SteveMayze/PowerSwap/Image/PowerSwap3d.png

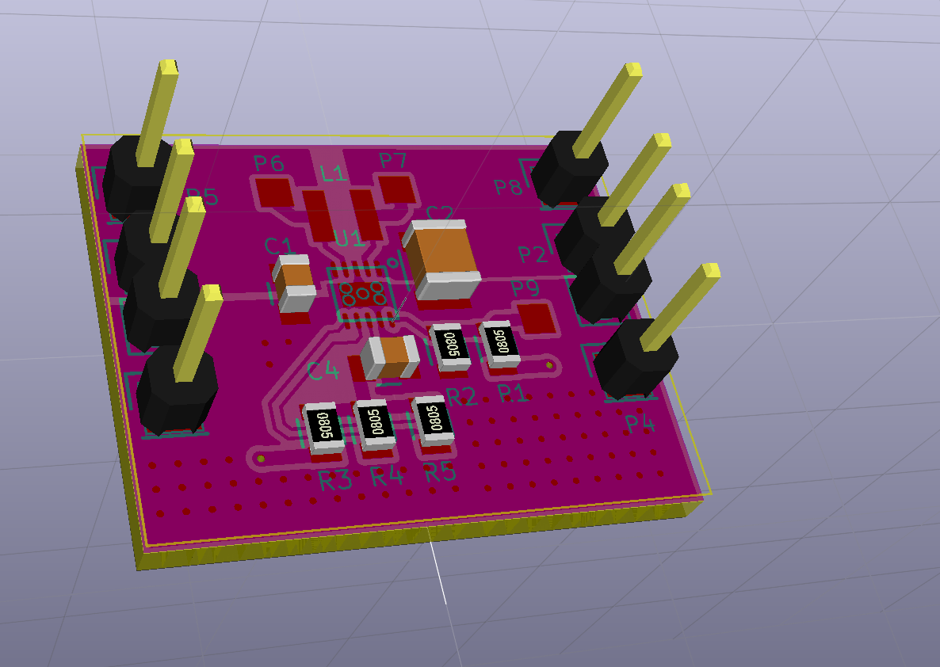
Image/PowerSwap3d.png
