SteveMayze/PowerSwap/Image/BuckBoost-TooMuchPaste.png

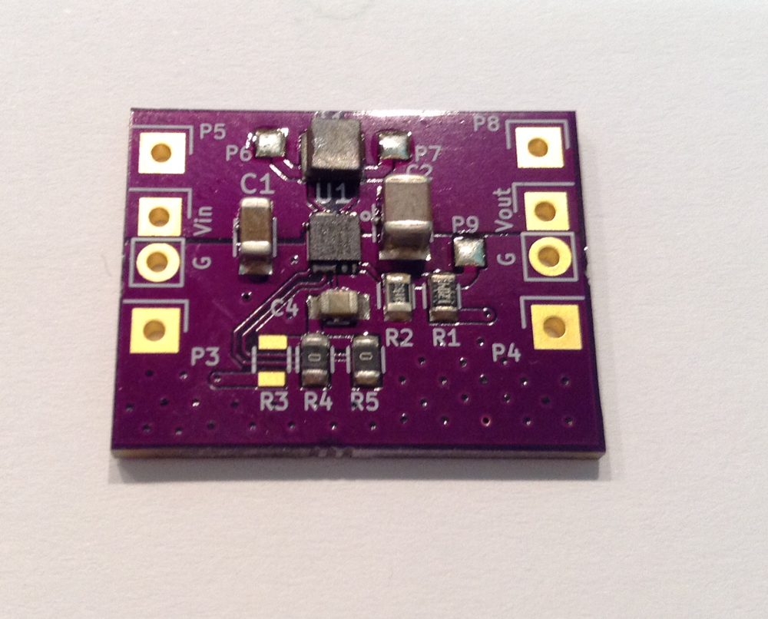
Image/BuckBoost-TooMuchPaste.png
