SteveMayze/PowerSwap/README.md

# PowerSwap
A Power control module for the Roll With it Project
