SteveMayze/PowerSwap/Boost/doc/Boost-Layout-Final.png

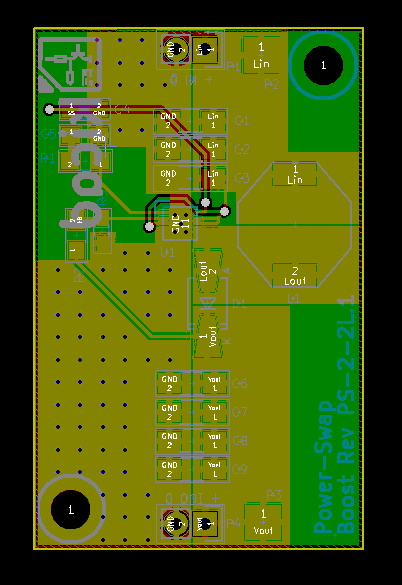
Boost/doc/Boost-Layout-Final.png
