SteveMayze/PowerSwap/Boost/doc/Boost-Layout.png

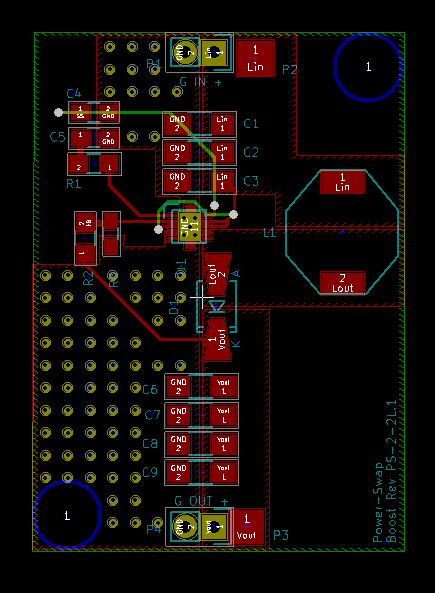
Boost/doc/Boost-Layout.png
