SteveMayze/PowerSwap/Boost/doc/PowerSwap-Boost-Connection.png

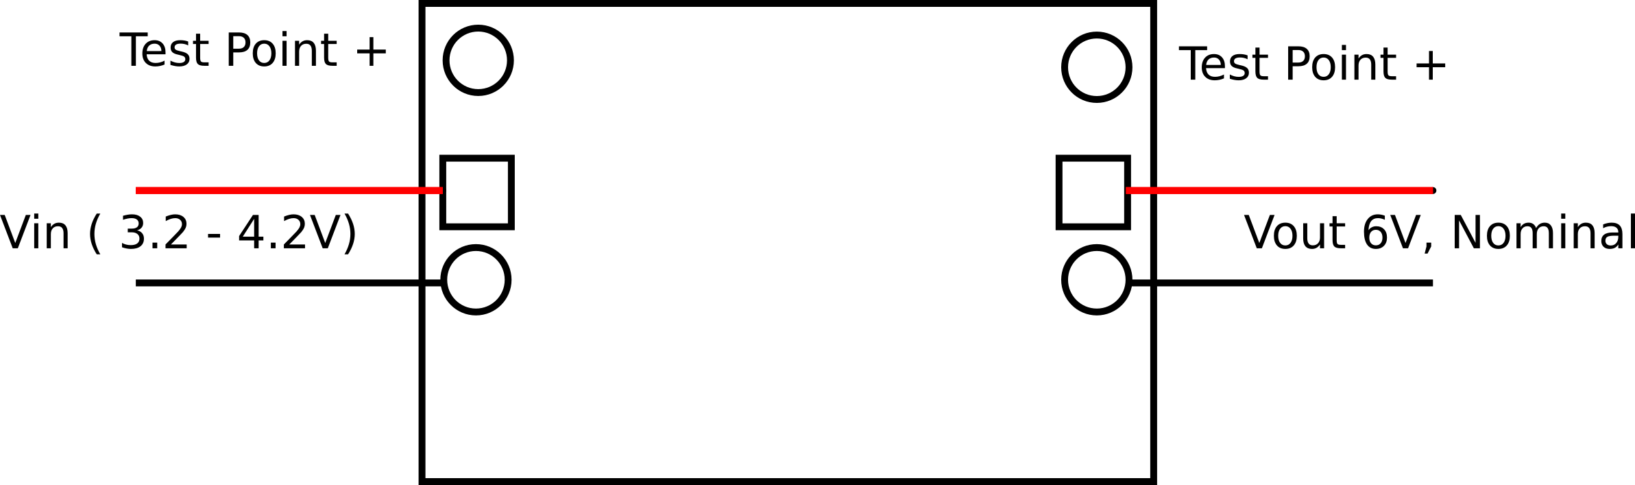
Boost/doc/PowerSwap-Boost-Connection.png
