SteveMayze/PowerSwap/Buck-Boost/doc/PowerSwap-BuckBoost-Connection.png

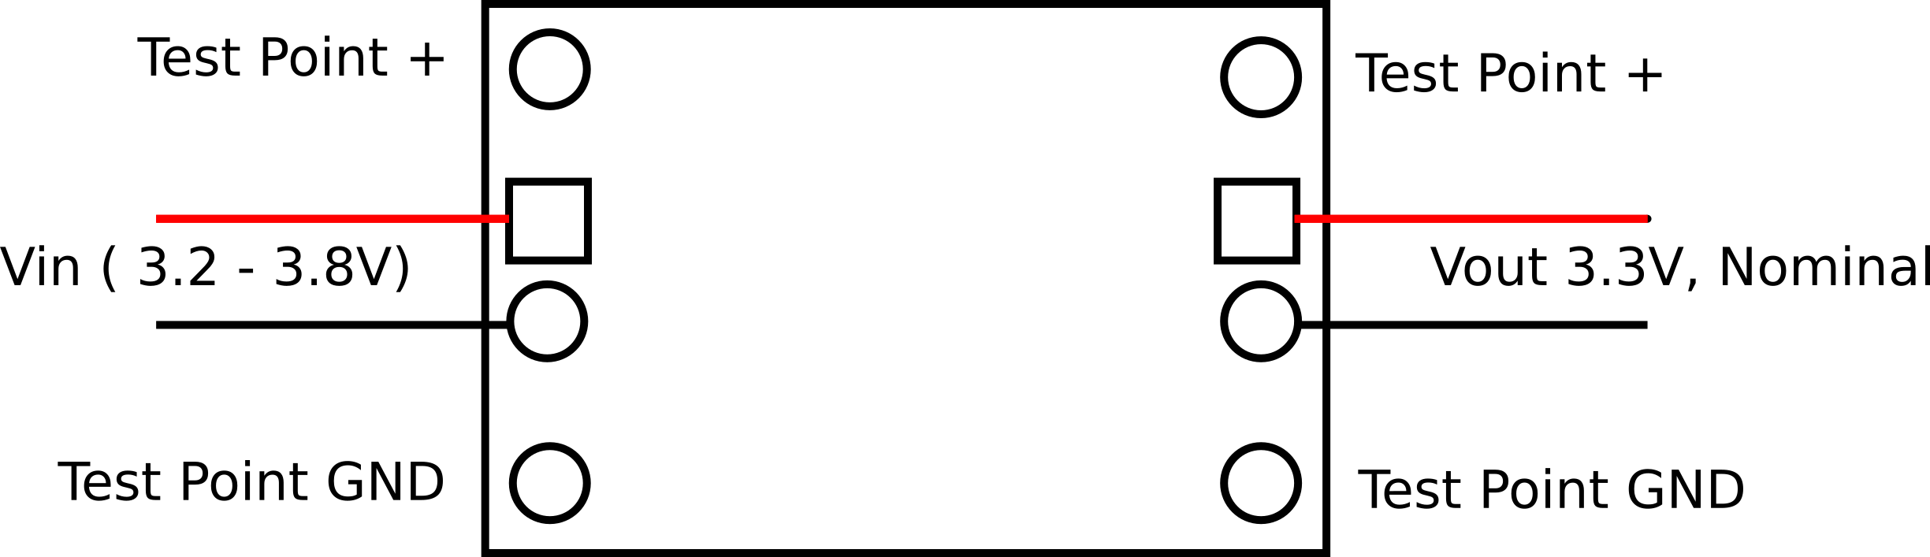
Buck-Boost/doc/PowerSwap-BuckBoost-Connection.png
