SteveMayze/PowerSwap/Image/Boost-InitialSchematic.png

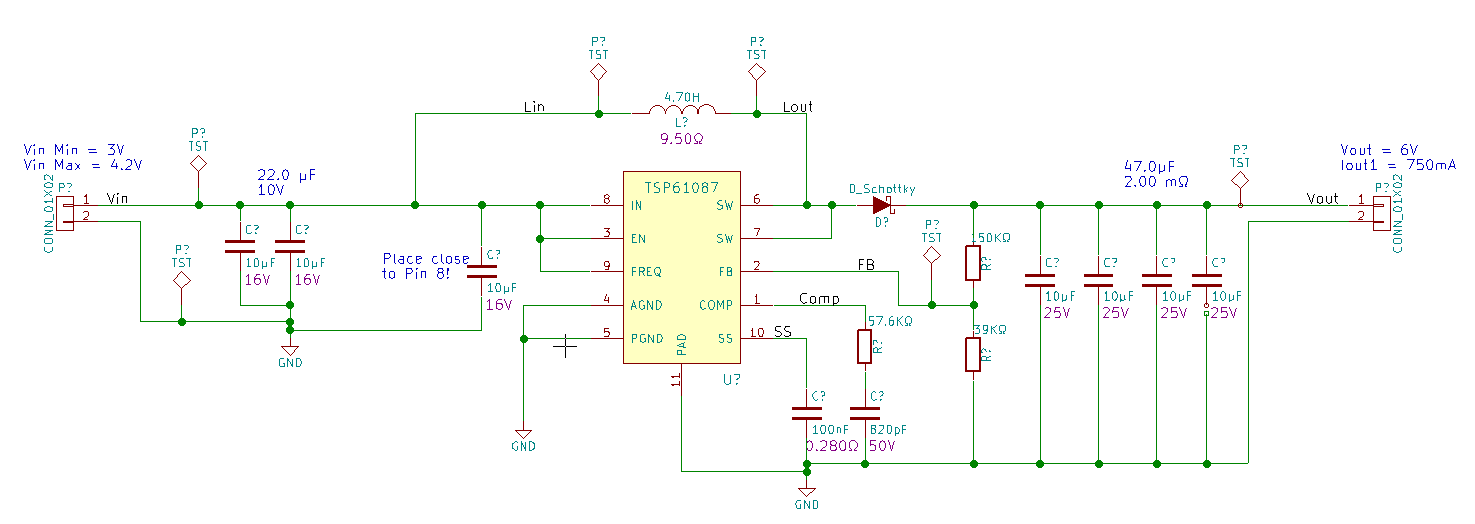
Image/Boost-InitialSchematic.png
