SteveMayze/PowerSwap/Image/Boost-ReferenceSchematic.png

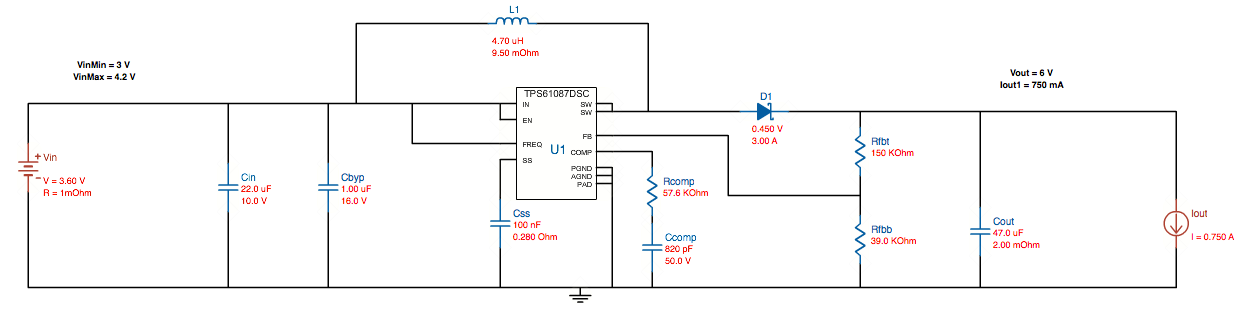
Image/Boost-ReferenceSchematic.png
