SteveMayze/PowerSwap/Image/BuckBoost-Working.png

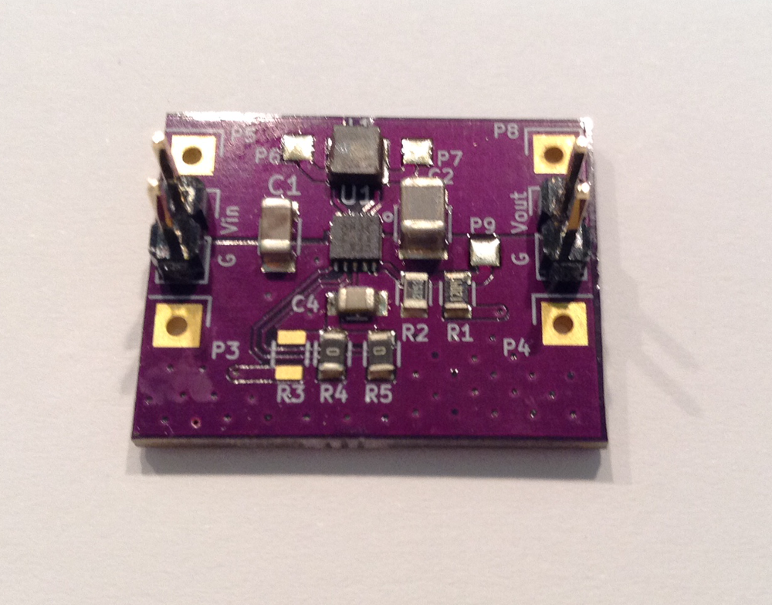
Image/BuckBoost-Working.png
