SteveMayze/PowerSwap/Image/BucknBoost3.png

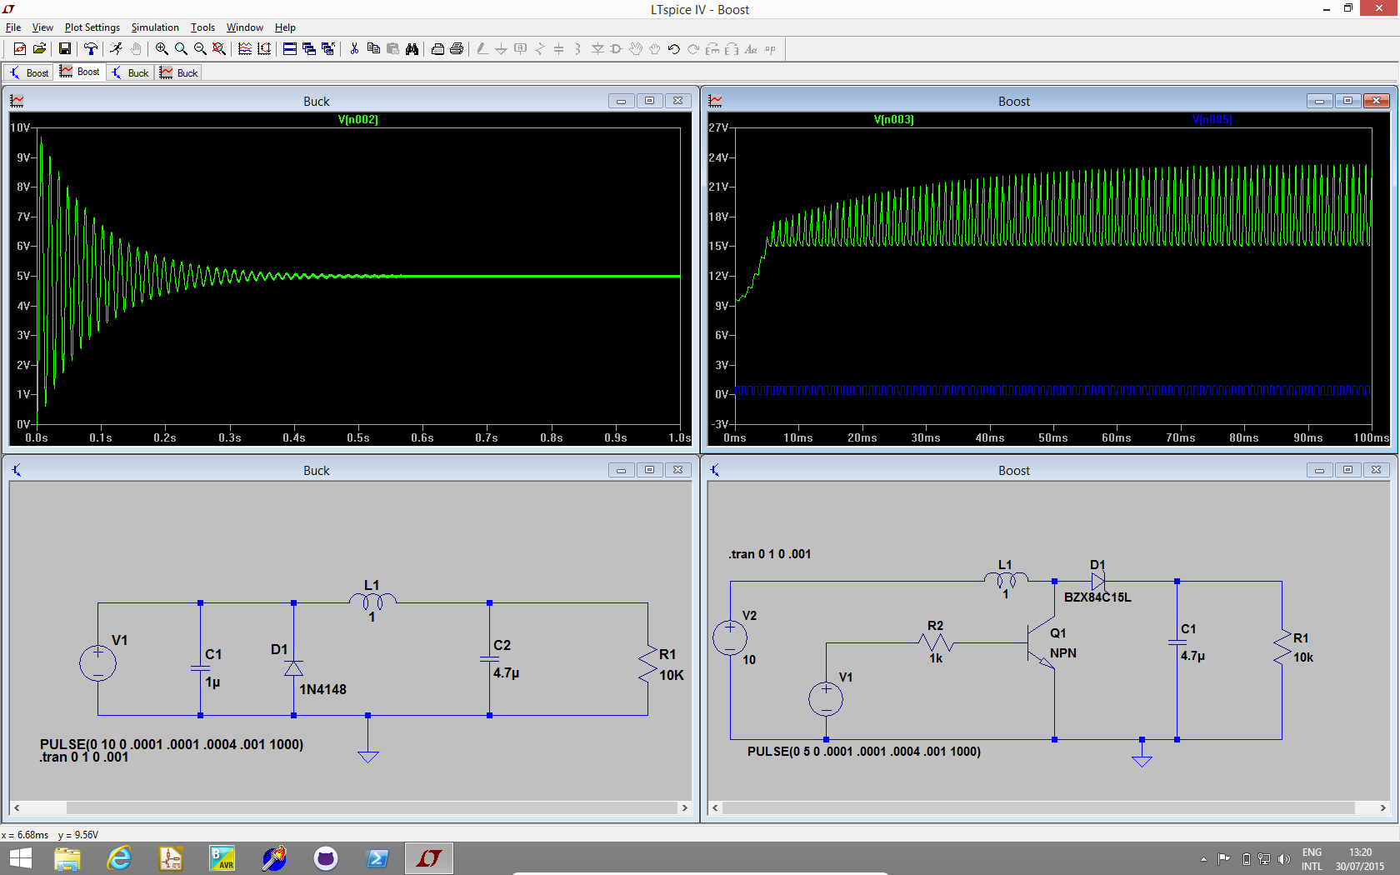
Image/BucknBoost3.png
