SteveMayze/PowerSwap/Image/PowerSwap-Boost-Schematic.png

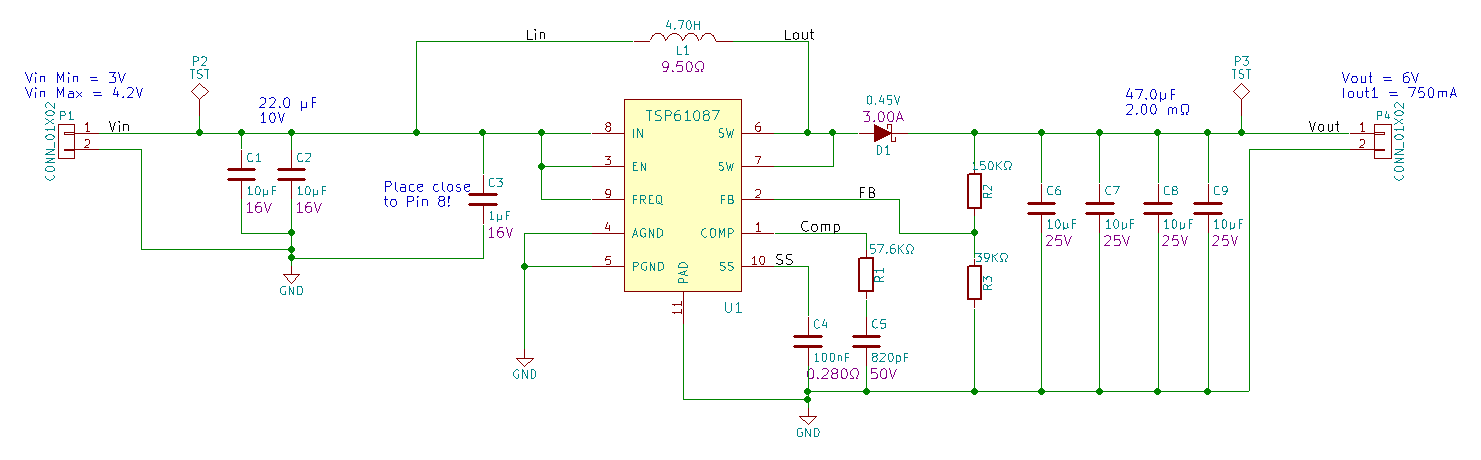
Image/PowerSwap-Boost-Schematic.png
