SteveMayze/PowerSwap/Image/PowerSwap-Layout-01.png

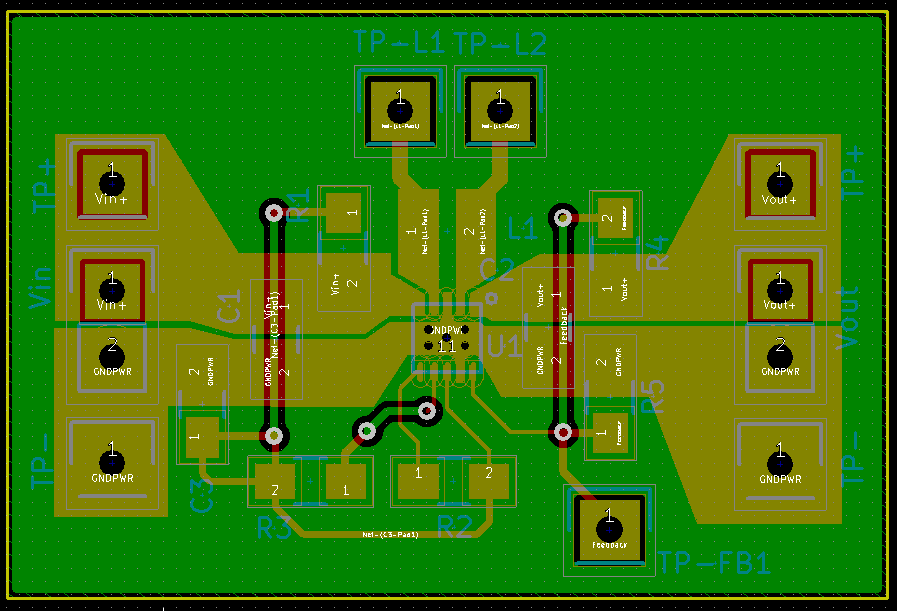
Image/PowerSwap-Layout-01.png
