SteveMayze/PowerSwap/Image/PowerSwap-Layout-BottomCopper.png

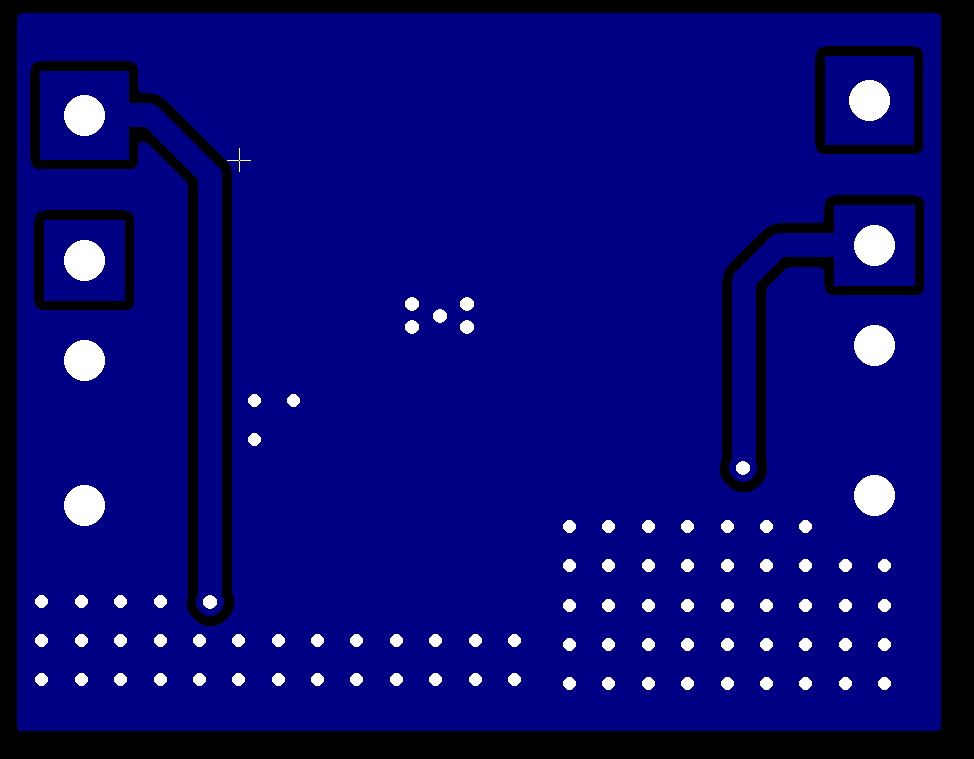
Image/PowerSwap-Layout-BottomCopper.png
