SteveMayze/PowerSwap/Image/PowerSwap-Layout-rev2.png

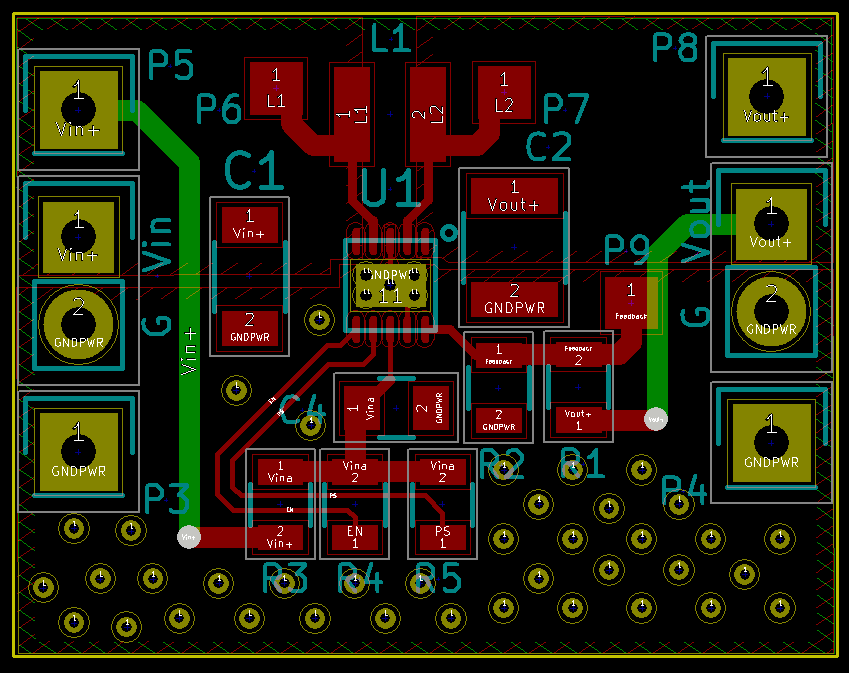
Image/PowerSwap-Layout-rev2.png
