SteveMayze/PowerSwap/Image/PowerSwap-Layout-TopCopper.png

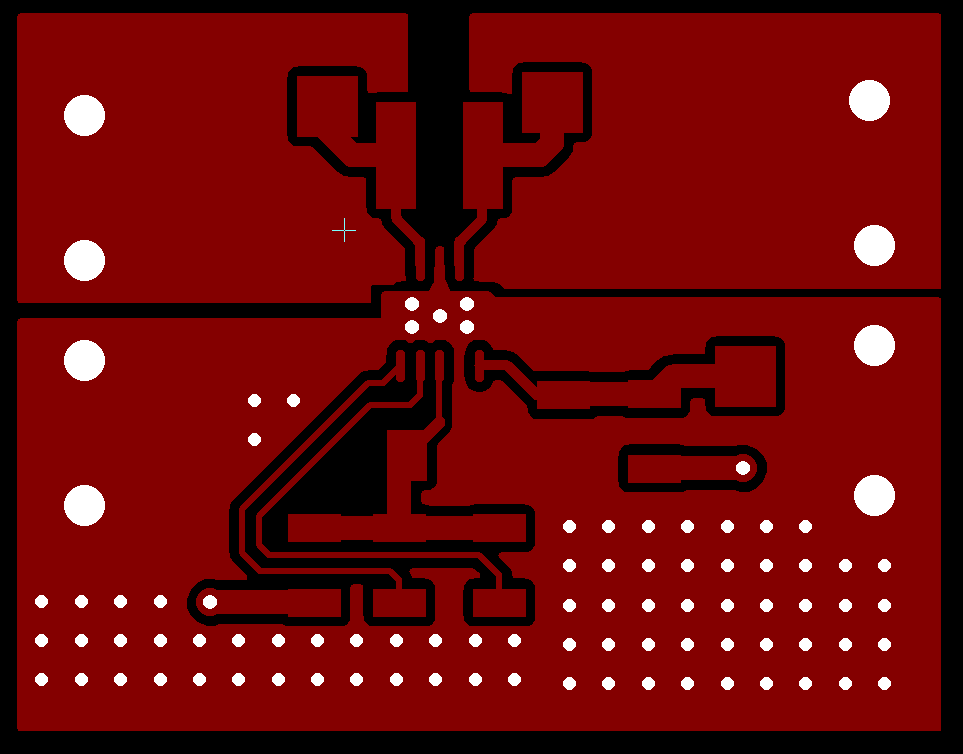
Image/PowerSwap-Layout-TopCopper.png
