SteveMayze/PowerSwap/Image/PowerSwap-Layout.png

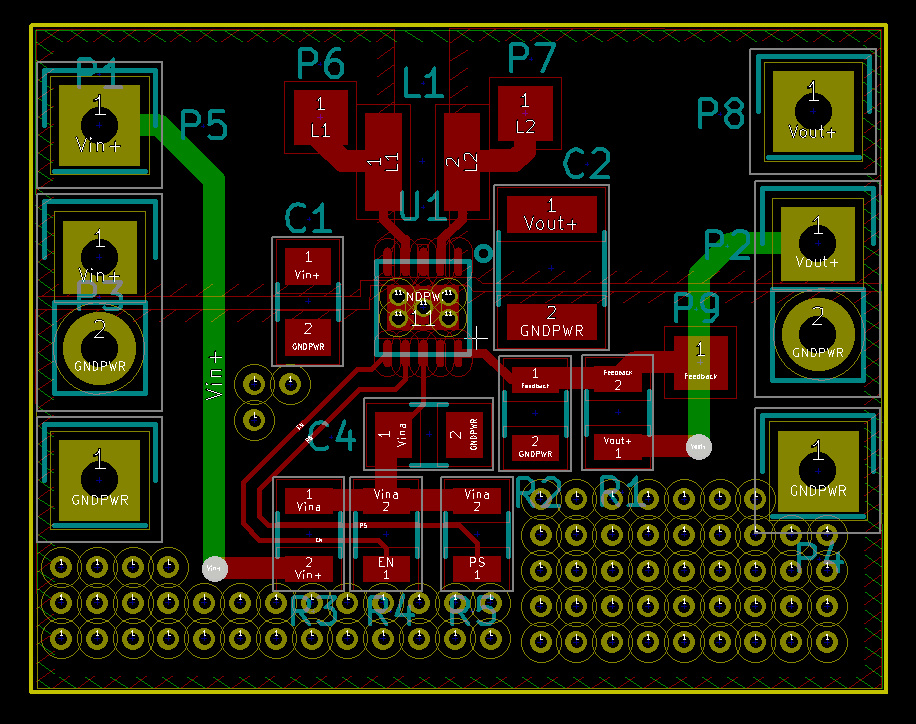
Image/PowerSwap-Layout.png
