SteveMayze/PowerSwap/Image/Schematic-150801.png

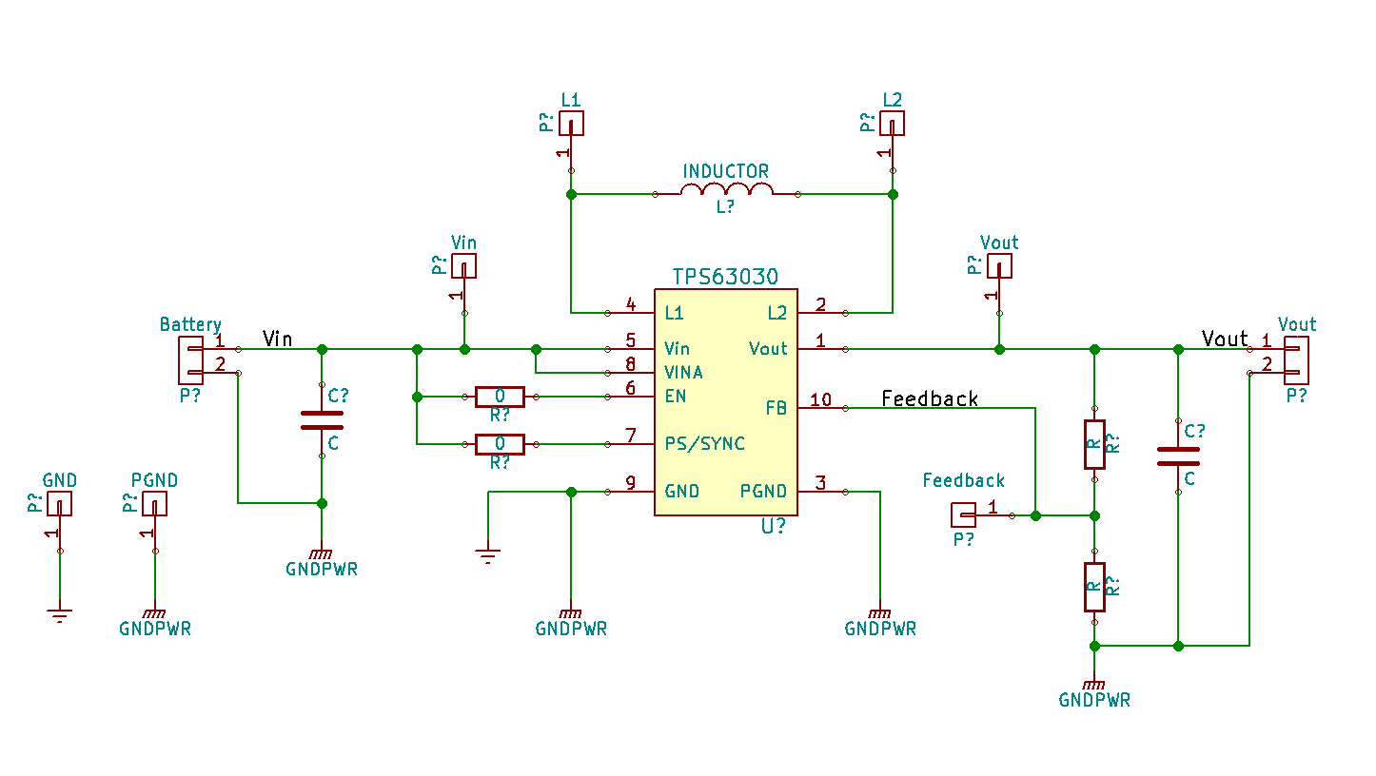
Image/Schematic-150801.png
