SteveMayze/PowerSwap/Image/Schematic-151121.png

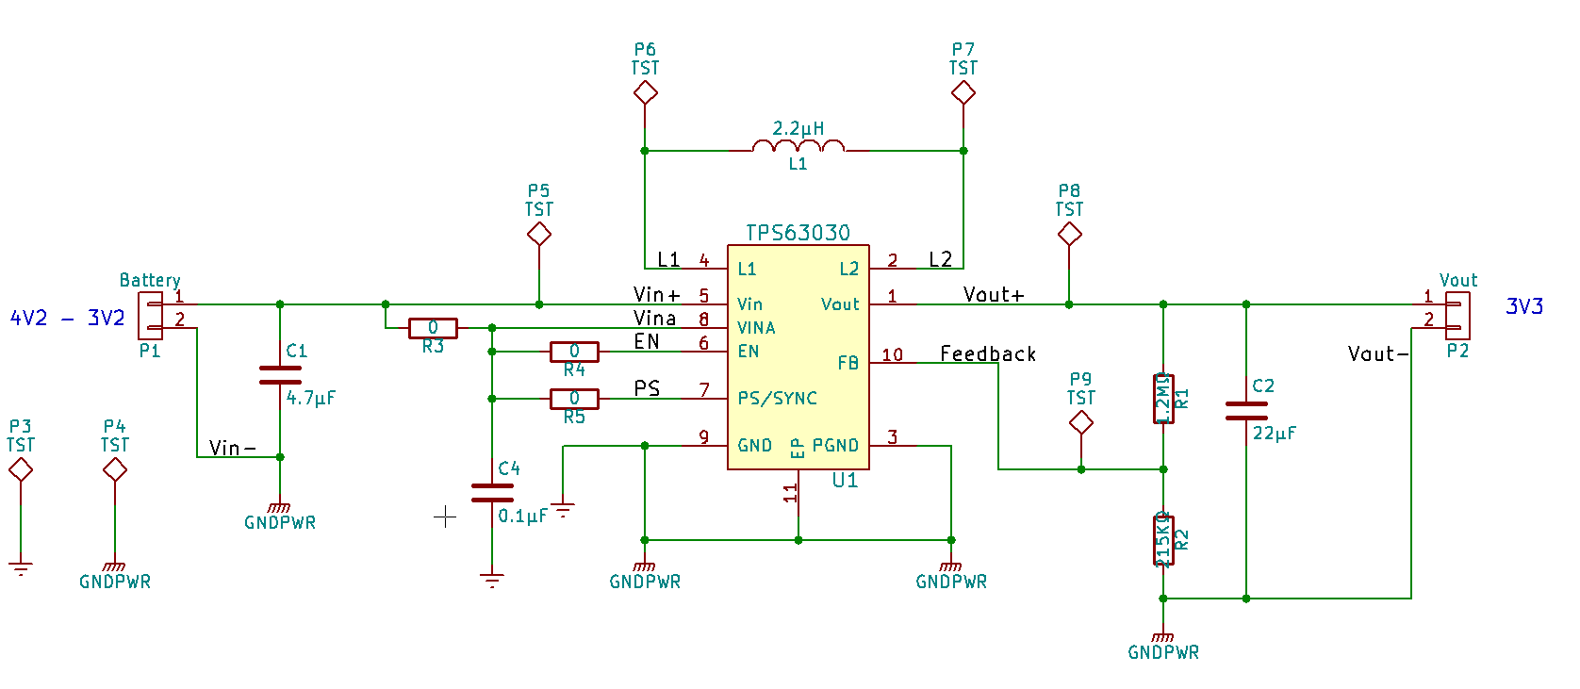
Image/Schematic-151121.png
