SteveMayze/PowerSwap/Buck-Boost/doc/ComponentValues.pdf

R1

Page 1

Vin2 | 3 V
Vin1 | 4.2 V
Vout | 3.3 V
Vfb | 0.5 V
R1 | 1204000 Ω
R2 | 215000 Ω | 2.33E-06

Inductor

Page 2

V from the data sheet calculations
Lbuck | 0.00000045 H | | 1.5 | 3
Lboost | 0.00000165 H | 0.0000022 | 4.7 | 6.1

Current

Page 3

f | 2200000.000 Hz
Iout | 0.100 A
I1 | 0.198 A | 0.222402597
I2 | 0.166 A

Cout

Page 4

E3
Cout | 0.000011 F | 22 μF
