SteveMayze/PowerSwap/Buck-Boost/doc/ComponentValues.numbers/preview-web.jpg

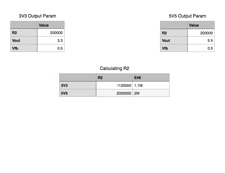
Buck-Boost/doc/ComponentValues.numbers/preview-web.jpg
