SteveMayze/PowerSwap/Boost/doc/PowerSwap-Boost-TestResults.pdf

## Test Results

## Constant Supply

The test results show the behaviour of the system with a constant supply voltage and varied load from 0 through to 600mA. The system load represents the current drawn by the system as reported on the laboratory power supply.

## 3.2V Constant supply

0 | 0.100 | 0.200 | 0.300 | 0.400 | 0.500 | 0.600

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
## Output Voltage by Load @ 3V2 (Boost)

Output Voltage System Load

Load Current (Amperes)

Output (Volts)

Load Current | Output Voltage System Load
0.000 | 5.970 | 0.003
0.100 | 5.960 | 0.215
0.200 | 5.960 | 0.420
0.300 | 5.960 | 0.663
0.400 | 5.960 | 0.951
0.500 | 5.960 | 1.265
0.600 | 4.560 | 1.150

## 4.2V Constant Supply

Load Current | Output Voltage | System Load
0.000 | 5.970 | 0.001
0.100 | 5.960 | 0.155
0.200 | 5.960 | 0.316
0.300 | 5.960 | 0.480
0.400 | 5.960 | 0.663
0.500 | 5.960 | 0.851
0.600 | 5.950 | 1.610
0.000 | 0.100 | 0.200 | 0.300 | 0.400 | 0.500 | 0.600

5.94

5.95

5.95

5.96

5.96

5.97

5.97

5.98

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
## Output Voltrage by Load @ 4V2 (Boost)

Output Voltage System Load

Load Current (Amperes)

Output (Volts)

## Connection

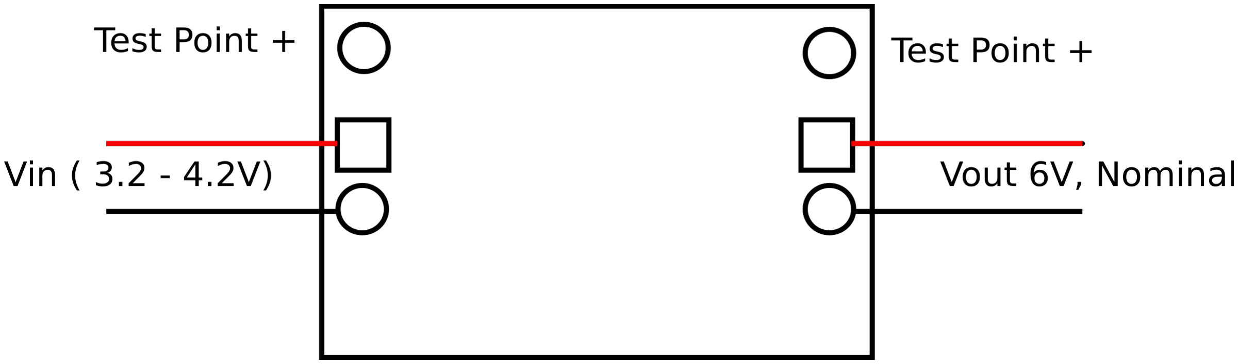
[picture p20: figure]

## Schematic

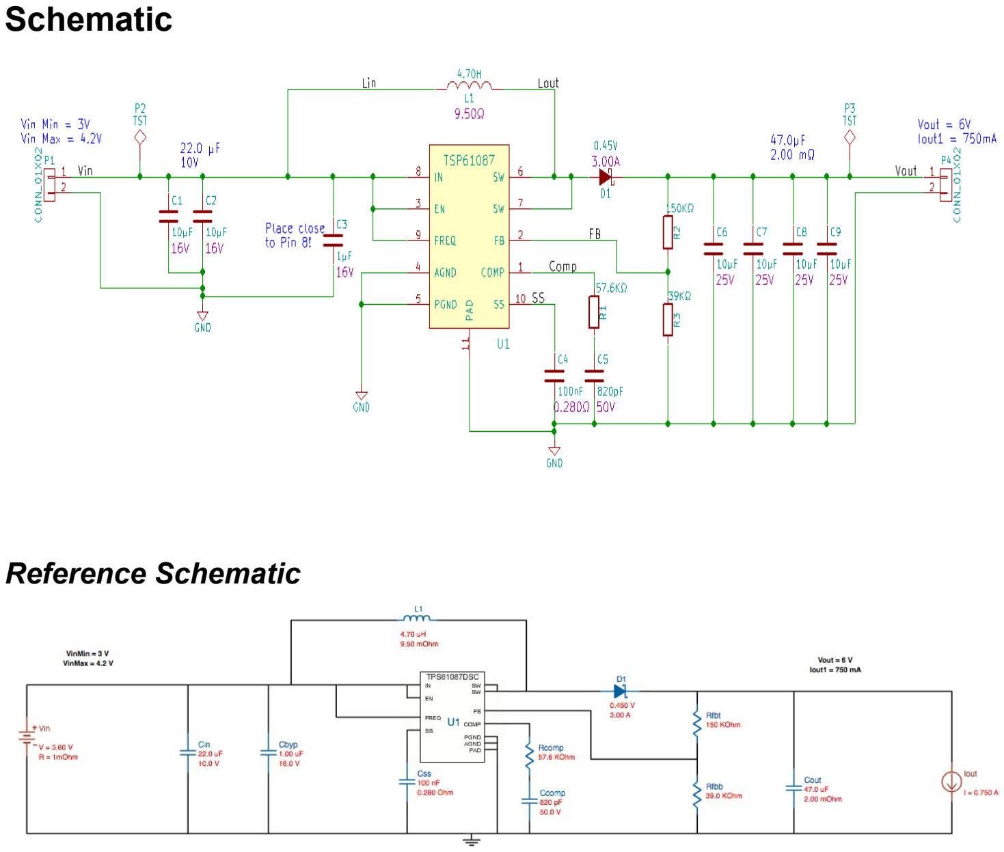
[picture p21: page 4]

## Reference Schematic
