SteveMayze/PowerSwap/Buck-Boost/doc/PowerSwap-BuckBoost-TestResults.pdf

# Test Results

# Constant Supply

The test results show the behaviour of the system with a constant supply voltage and varied load from 0 through to 500mA. The system load represents the current drawn by the system as reported on the laboratory power supply.

Load Current | Output Voltage | System Load
0.000 | 3.279 | 0.005
0.100 | 3.274 | 0.085
0.200 | 3.270 | 0.173
0.300 | 3.266 | 0.266
0.400 | 3.262 | 0.363
0.500 | 3.261 | 0.483
0.000 | 0.100 | 0.200 | 0.300 | 0.400 | 0.500

3.25

3.26

3.27

3.28

0

0.1

0.2

0.3

0.4

0.5

0.6

# Output Voltage by Load @ 4V2 (Buck)

# Output Voltage System Load

# Load Current

# Ouput Voltage

# Input Voltage3.2V

# Load CurrentOutput Voltage System Load

0.000 | 3.279 | 0.005
0.100 | 3.278 | 0.113
0.200 | 3.279 | 0.230
0.300 | 3.279 | 0.375
0.400 | 3.282 | 0.530
0 | 0.1 | 0.2 | 0.3 | 0.4 | 0.5

3.24

3.26

3.28

3.3

# Output Voltage by Load @ 3V2 (Boost)

# Load Current

# Output Voltage

# System Test

The results show the behaviour of a full system test. This is the Power Swap Buck-Boost module being supplied by the Full Charge Ahead (FCA) module, which is also charging a Lithium ION battery. An active load will be simulated using the Current Sink or Swim (CSoS) module.
The idea is to ascertain how the system will behave over time under load with no charge and then again with a constant charge from the FCA module.

# Set up

The modules are interconnected as per the diagram below. The CSoS acts as an active load drawing current from the Li-ION cell via the Power Swap Buck-Boost module. It is expected that the CSoS is delivered the required current at a constant voltage of 3.3V.

# Expected Behaviour

When the system is supplied from an external source i.e. 5V supply via the USB connector, it is expected that there should be no variation in the behaviour of the system. Once the 5V supply is removed (on a fully charged system) no immediate change is expected from the perspective of the active load. The system will deliver the required current at the constant 3.3V.
After some time, the Lithium-ION cell will reduce its output voltage in the range from 4.2V down to about 3.2V before shutting off entirely. During this, the Power Swap Buck-Boost module will switch from Buck mode to Boost mode to continue to deliver the required current at 3.3V.

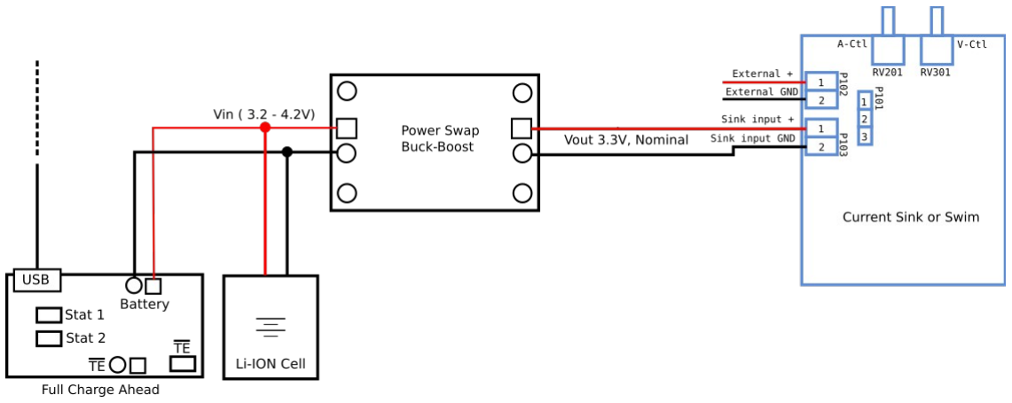
[picture p22: figure]

# Results

# Discharge

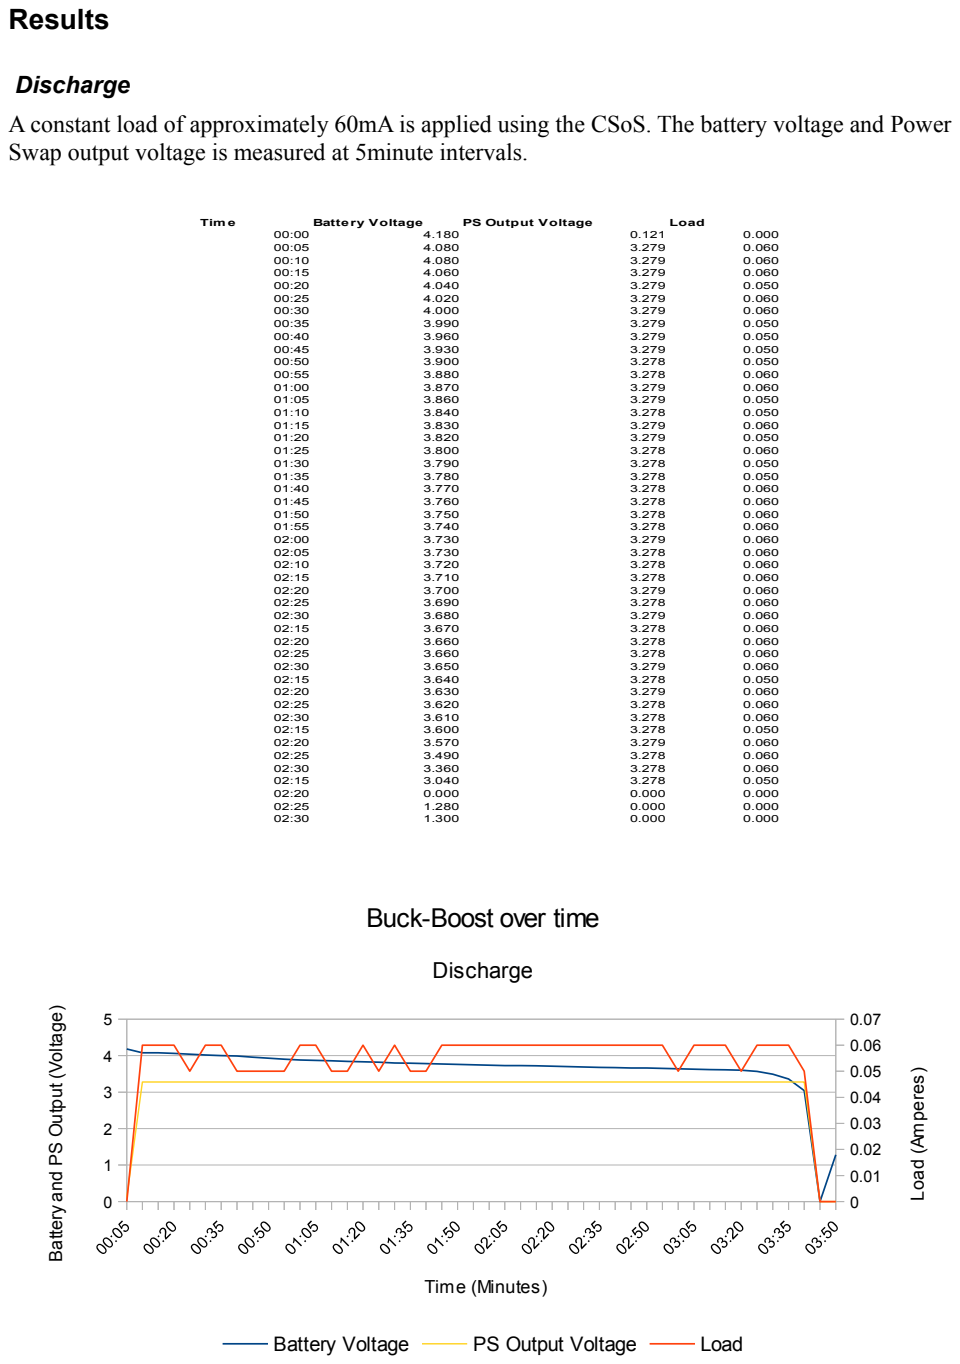
[picture p23: page 3]
Time; Battery Voltage; PS Output Voltage; Load; Discharge; Time (Minutes); Battery and P; Output (Voltage); Load (Amperes)

A constant load of approximately 60mA is applied using the CSoS. The battery voltage and Power
Swap output voltage is measured at 5minute intervals.

Buck-Boost over time

# Recharge

The USB supply was added to the system. It was found that neither the CSoS or Power Swap could

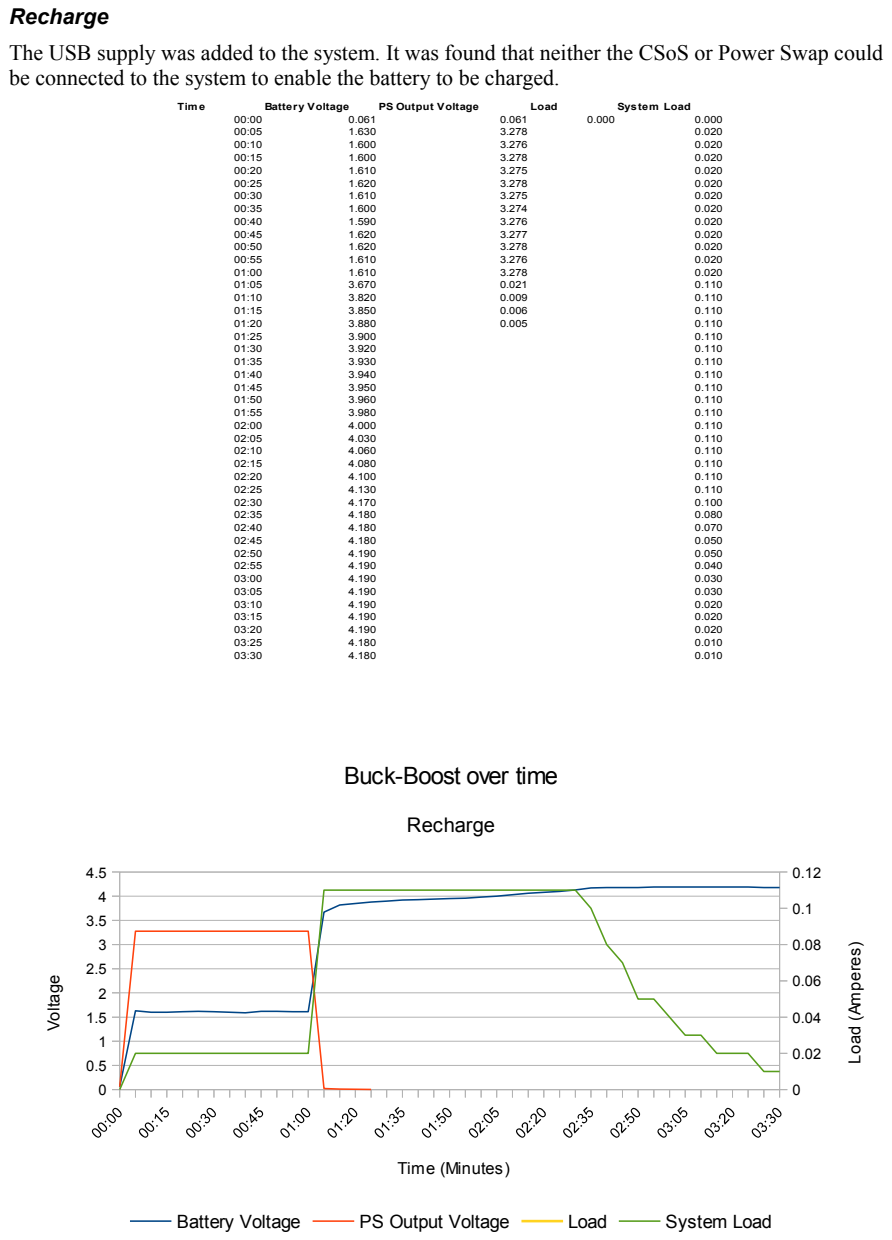
[picture p24: page 4]
Time; Battery Voltage; PS Output Voltage; Load; System Load; Recharge; Time (Minutes); Voltage; Load (Amperes)

be connected to the system to enable the battery to be charged.

Buck-Boost over time

# Recharge Under Load

It was found during the recharge that the a completely depleted battery can not be effectively charged with the FCA with the Power Swap or CSoS connected. A further test is performed here to check the behaviour of the system when the batter is not completely depleted.
The results show that it is possible for the FCA to charge the battery and supply the System. However, the FCA will not indicate that the battery is fully charged – only when removing the Power Swap from the system will the FCA indicate a fully charged battery.
Time | Battery Voltage | PS Output Voltage | Load
00:00 | 4.170 | 0.000 | 0.000
00:05 | 4.170 | 0.000 | 0.000
00:10 | 4.160 | 3.279 | 0.000
00:15 | 4.160 | 3.279 | 0.000
00:20 | 4.080 | 3.279 | 0.060
00:25 | 4.060 | 3.278 | 0.060
00:30 | 4.030 | 3.278 | 0.060
00:35 | 4.010 | 3.278 | 0.060
00:40 | 3.990 | 3.278 | 0.060
00:45 | 3.980 | 3.278 | 0.060
00:50 | 3.940 | 3.278 | 0.060
00:55 | 3.910 | 3.278 | 0.060
01:00 | 3.880 | 3.278 | 0.060
01:05 | 3.870 | 3.278 | 0.060
01:10 | 3.850 | 3.278 | 0.060
01:15 | 3.840 | 3.278 | 0.060
01:20 | 3.820 | 3.278 | 0.060
01:25 | 3.810 | 3.279 | 0.060
01:30 | 3.790 | 3.278 | 0.060
01:35 | 3.780 | 3.278 | 0.060
01:40 | 3.760 | 3.278 | 0.060
01:45 | 3.750 | 3.278 | 0.060
01:50 | 3.740 | 3.278 | 0.060
01:55 | 3.730 | 3.278 | 0.060
02:00 | 3.720 | 3.278 | 0.060
02:05 | 3.710 | 3.278 | 0.060
02:10 | 3.700 | 3.278 | 0.060
02:15 | 3.690 | 3.278 | 0.060
02:20 | 3.690 | 3.278 | 0.060
02:25 | 3.680 | 3.278 | 0.060
02:30 | 3.830 | 3.278 | 0.060
02:35 | 3.850 | 3.278 | 0.060
02:40 | 3.860 | 3.278 | 0.060
02:45 | 3.870 | 3.278 | 0.060
02:50 | 3.870 | 3.278 | 0.060
02:55 | 3.880 | 3.278 | 0.060
03:00 | 3.890 | 3.278 | 0.060
03:05 | 3.900 | 3.278 | 0.060
03:10 | 3.910 | 3.278 | 0.060
03:15 | 3.920 | 3.278 | 0.060
03:20 | 3.930 | 3.278 | 0.060
03:25 | 3.940 | 3.278 | 0.060
03:30 | 3.960 | 3.278 | 0.060
03:15 | 3.970 | 3.278 | 0.060
03:20 | 3.990 | 3.278 | 0.060
03:25 | 4.000 | 3.278 | 0.060
03:30 | 4.020 | 3.278 | 0.060
03:15 | 4.030 | 3.278 | 0.060
03:20 | 4.040 | 3.279 | 0.060
03:25 | 4.050 | 3.278 | 0.060
03:30 | 4.070 | 3.278 | 0.060
03:15 | 4.100 | 3.279 | 0.060
03:20 | 4.140 | 3.279 | 0.060
03:25 | 4.160 | 3.278 | 0.060
03:30 | 4.170 | 3.278 | 0.060
03:35 | 4.180 | 3.278 | 0.060
03:40 | 4.180 | 3.278 | 0.060
03:45 | 4.180 | 3.278 | 0.060
03:50 | 4.180 | 3.278 | 0.060
03:55 | 4.190 | 3.278 | 0.060
04:00 | 4.190 | 3.278 | 0.060
04:05 | 4.190 | 3.278 | 0.060
04:10 | 4.190 | 3.278 | 0.060
04:15 | 4.190 | 3.278 | 0.060
04:20 | 4.190 | 3.278 | 0.060

3.5

4

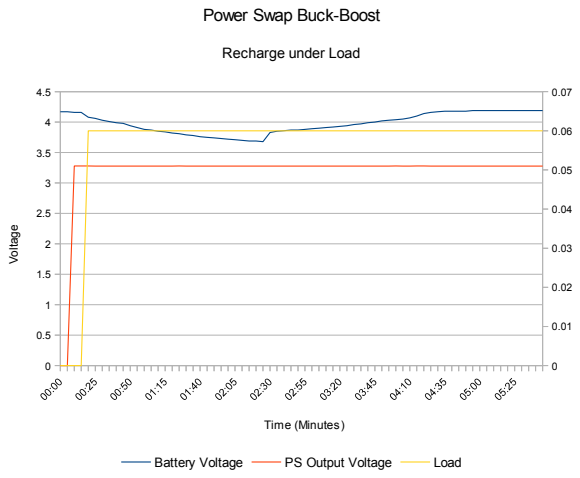
[picture p25: page 6]
Battery Voltage; PS Output Voltage; Load; Time (Minutes); Voltage

Power Swap Buck-Boost

Recharge under Load

# Connection

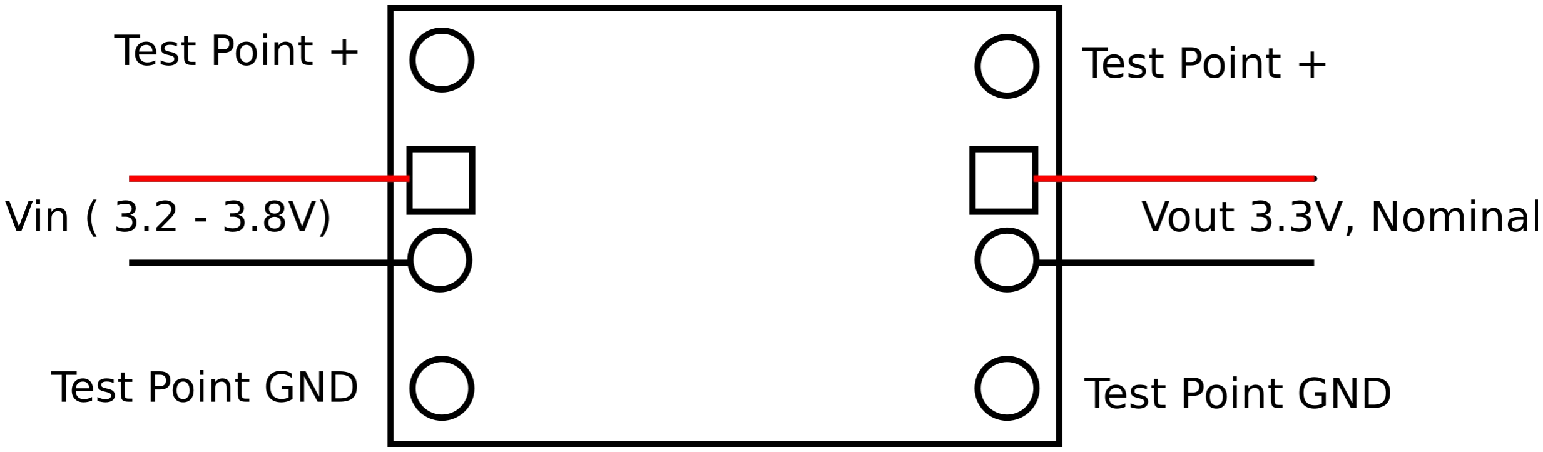
[picture p26: figure]

# Schematic

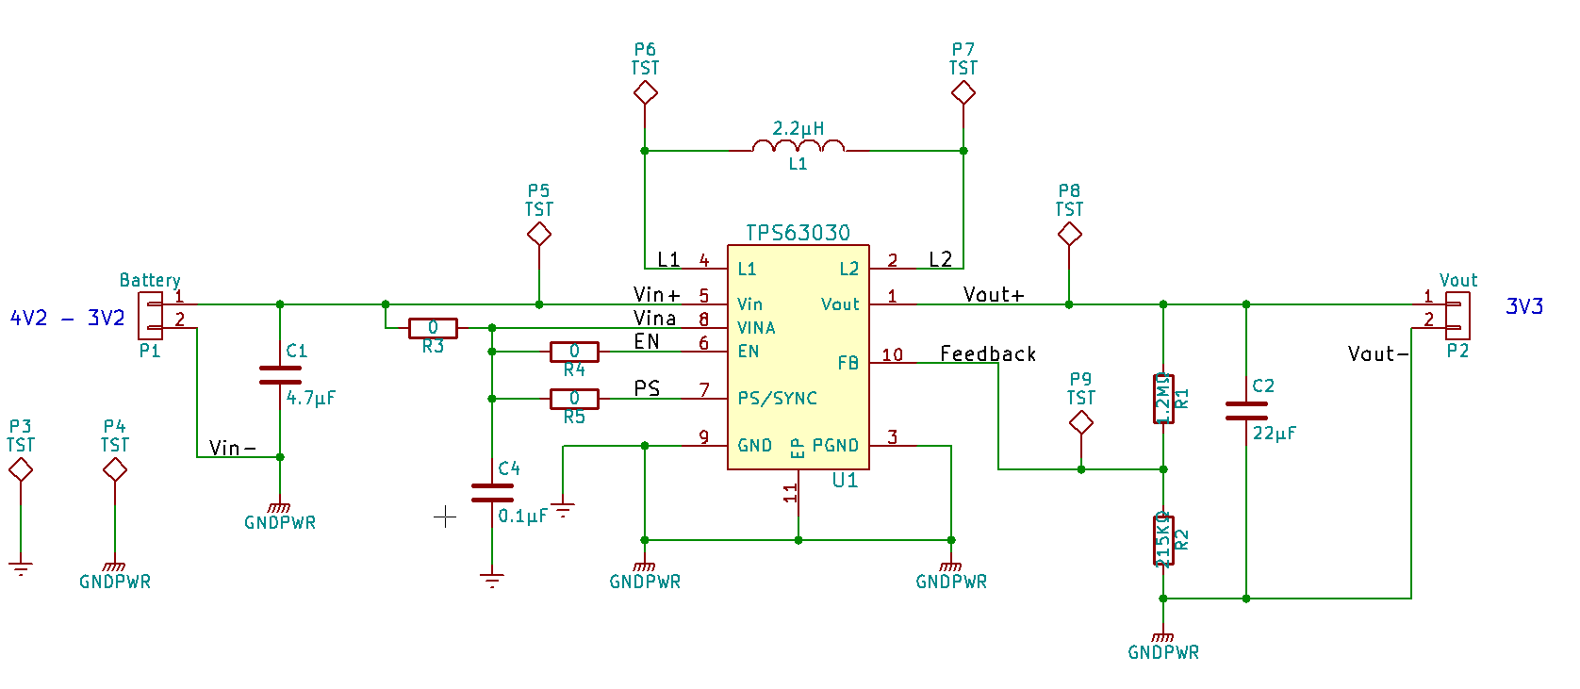
[picture p27: figure]
