SteveMayze/PowerSwap/Boost/doc/PowerSwap-Boost-TestResults.ods

Sheet: Const.3V2
Input Voltage | 3.2V
Load Current | Output Voltage | System Load
0.000 | 5.970 | 0.003
0.100 | 5.960 | 0.215
0.200 | 5.960 | 0.420
0.300 | 5.960 | 0.663
0.400 | 5.960 | 0.951
0.500 | 5.960 | 1.265
0.600 | 4.560 | 1.150

Sheet: Const. 4V2
Input Voltage | 4.2V
Load Current | Output Voltage | System Load
0.000 | 5.970 | 0.001
0.100 | 5.960 | 0.155
0.200 | 5.960 | 0.316
0.300 | 5.960 | 0.480
0.400 | 5.960 | 0.663
0.500 | 5.960 | 0.851
0.600 | 5.950 | 1.610

Sheet: System Test - Discharge
Time | Battery Voltage | Output Voltage | Load
00:00 |  |  | 0.100 | 150mAh
00:10
00:20
00:30
00:40
00:50
01:00
01:10
01:20
01:30
01:40
01:50
01:55
01:57

Sheet: System Test - Discharge Full
Time | Battery Voltage | PS Output Voltage | Load | System Load
00:00
00:05
00:10
00:15 |  |  |  |  | The charger does not have the capacity to drive 100mA plus charge the cell
00:20 |  |  |  |  | 110mA Charge current
00:25
00:30
00:35
00:40
00:45
00:50
00:55
01:00
01:05
01:10
01:15
01:20
01:25
01:30
01:35
01:40
01:45
01:50
01:55
02:00
02:05
02:10
02:15
02:20
02:25
02:30
02:15
02:20
02:25
02:30
02:15
02:20
02:25
02:30
02:15
02:20
02:25
02:30
02:15
02:20
02:25
02:30

Sheet: System Test - Recharge Full
Time | Battery Voltage | PS Output Voltage | Load | System Load
00:00
00:05
00:10
00:15
00:20
00:25
00:30
00:35
00:40
00:45
00:50
00:55
01:00
01:05
01:10
01:15
01:20
01:25
01:30
01:35
01:40
01:45
01:50
01:55
02:00
02:05
02:10
02:15
02:20
02:25
02:30
02:35
02:40
02:45
02:50
02:55
03:00
03:05
03:10
03:15
03:20
03:25
03:30

Sheet: System Test - Recharche under load
Time | Battery Voltage | PS Output Voltage | Load | System Load
00:00 |  |  |  |  |  | With the system under charge, add a load – 60mA
00:05 |  |  |  |  |  | Remove the charge until 3.7V
00:10 |  |  |  |  | Connected the Power Swap | Apply the charge.
00:15 |  |  |  |  | Connected CSoS no load
00:20 |  |  |  |  | Applied 60mA Load
00:25 |  |  |  |  | Removed the USB power
00:30
00:35
00:40
00:45
00:50
00:55
01:00
01:05
01:10
01:15
01:20
01:25
01:30
01:35
01:40
01:45
01:50
01:55
02:00
02:05
02:10
02:15
02:20
02:25 |  |  |  |  | Switched on the charger now!
02:30
02:35
02:40
02:45
02:50
02:55
03:00
03:05
03:10
03:15
03:20
03:25
03:30
03:35
03:40
03:45
03:50
03:55
04:00
04:05
04:10
04:15
04:20
04:25
04:30
04:35
04:40
04:45
04:50
04:55
05:00
05:05
05:10
05:15
05:20
05:25
05:30
05:35
05:40
05:45
