SteveMayze/PowerSwap/Buck-Boost/doc/PowerSwap-BuckBoost-TestResults.ods

Sheet: Const.3V2
Input Voltage | 3.2V
Load Current | Output Voltage | System Load
0.000 | 3.279 | 0.005
0.100 | 3.278 | 0.113
0.200 | 3.279 | 0.230
0.300 | 3.279 | 0.375
0.400 | 3.282 | 0.530
0.500 | 3.260 | 0.736

Sheet: Const.4V2
Input Voltage | 4.2V
Load Current | Output Voltage | System Load
0.000 | 3.279 | 0.005
0.100 | 3.274 | 0.085
0.200 | 3.270 | 0.173
0.300 | 3.266 | 0.266
0.400 | 3.262 | 0.363
0.500 | 3.261 | 0.483

Sheet: System Test - Discharge
Time | Battery Voltage | Output Voltage | Load
00:00 | 4.060 | 3.280 | 0.100 | 150mAh
00:10 | 3.970 | 3.280
00:20 | 3.900 | 3.280
00:30 | 3.810 | 3.280
00:40 | 3.770 | 3.280
00:50 | 3.724 | 3.280
01:00 | 3.678 | 3.280
01:10 | 3.640 | 3.280
01:20 | 3.607 | 3.280
01:30 | 3.570 | 3.280
01:40 | 3.522 | 3.280
01:50 | 3.275 | 3.280
01:55 | 2.700 | 3.280
01:57 | 0.000 | 0.000
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
