SteveMayze/PowerSwap/Image/test-b2.png

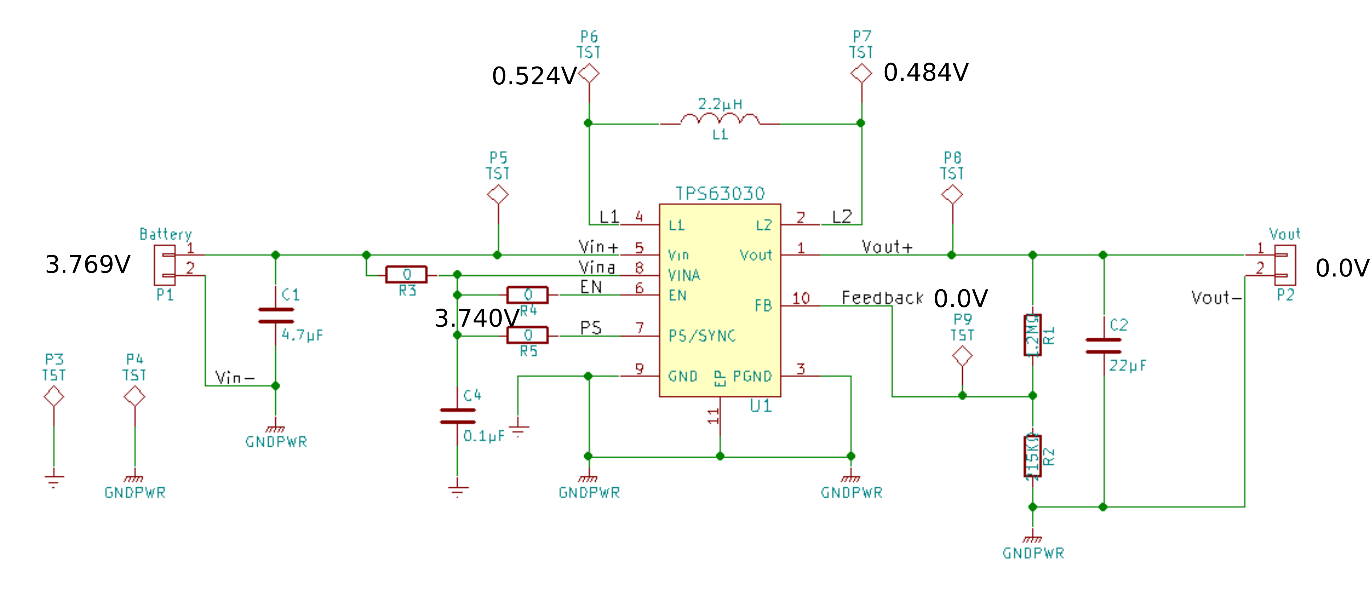
Image/test-b2.png
