SteveMayze/PowerSwap/Boost/doc/webench_design_4530725_5_678277622.pdf

## WEBENCH ® Design Report

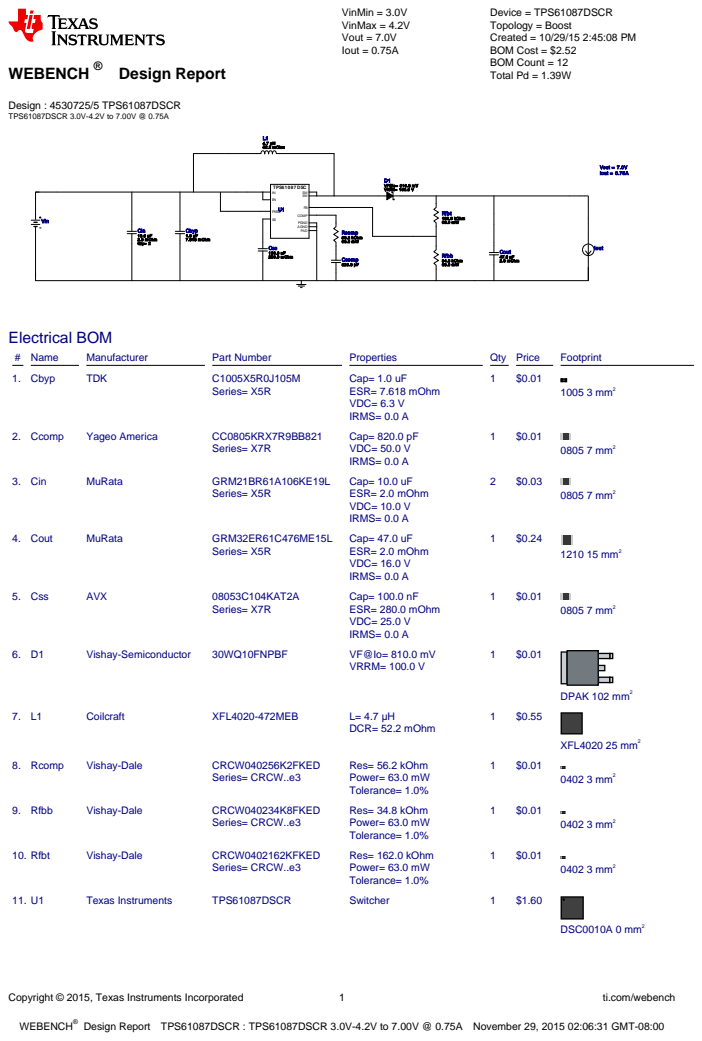
[picture p29: page 1]
Copyright © 2015, Texas Instruments Incorporated; ti.com/webench; WEBENCH®; Design : 4530725/5 TPS61087DSCR TPS61087DSCR 3.0V-4.2V to 7.00V @ 0.75A; VinMin = 3.0V VinMax = 4.2V Vout = 7.0V Iout = 0.75A; Device = TPS61087DSCR Topology = Boost Created = 10/29/15 2:45:08 PM BOM Cost = $2.52 BOM Count = 12 Total Pd = 1.39W; Cbyp 1.0 µF 7.618 mOhm; Ccomp 820.0 pF; Cin 10.0 µF 2.0 mOhm; Qty= 2; Cout 47.0 µF; 2.0 mOhm; Css 100.0 nF 280.0 mOhm; D1 VF@Io= 810.0 mV VRRM= 100.0 V; L1 4.7 µH 52.2 mOhm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

Design Report TPS61087DSCR : TPS61087DSCR 3.0V-4.2V to 7.00V @ 0.75A November 29, 2015 02:06:31 GMT-08:00

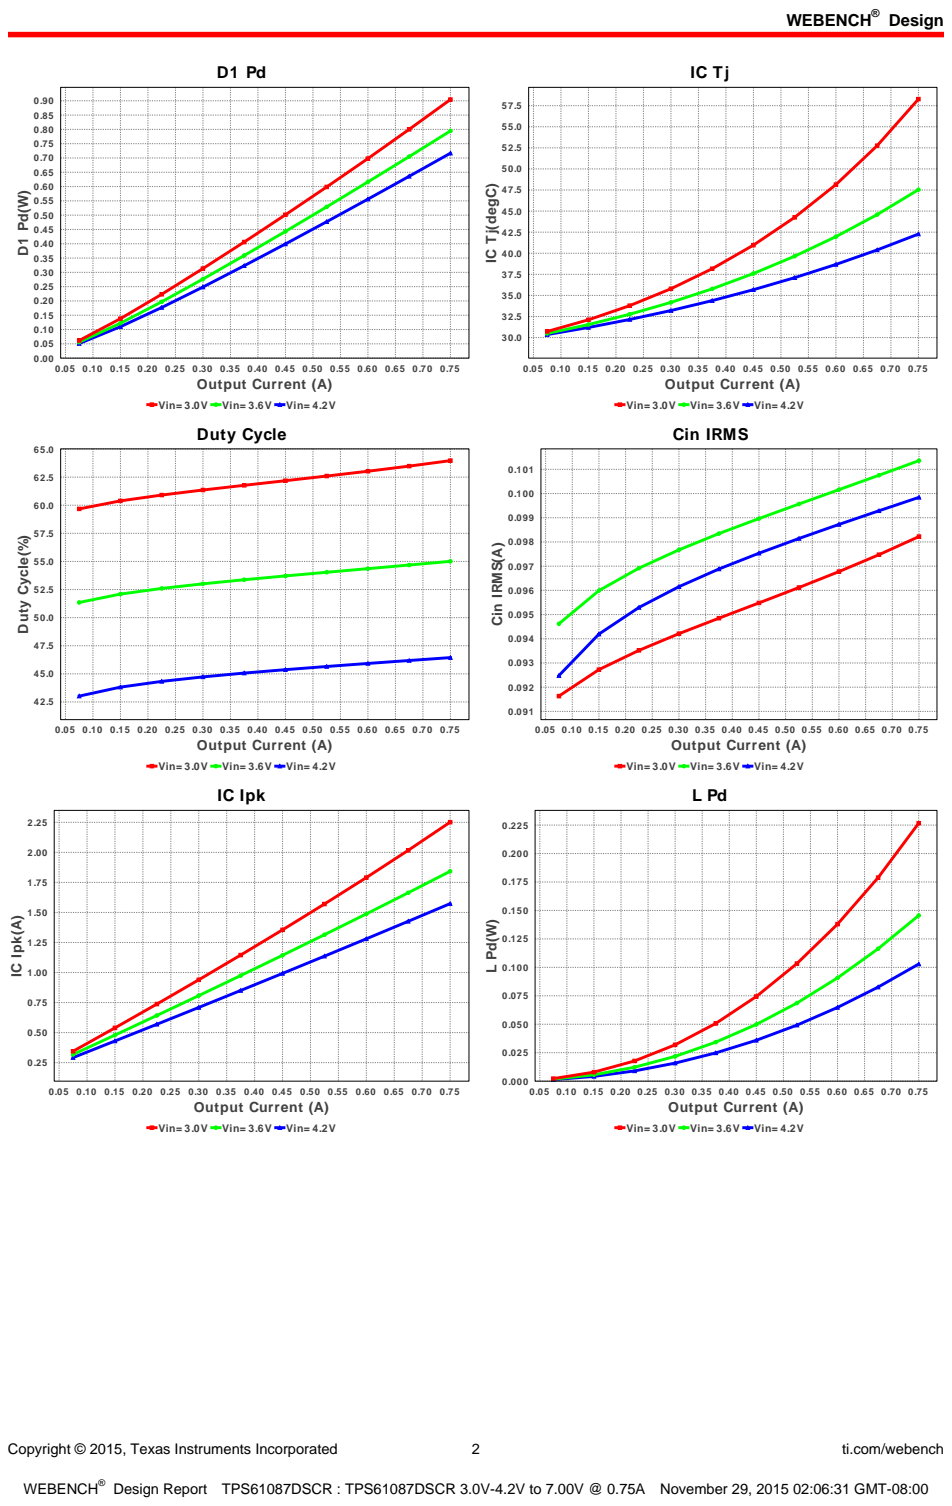
[picture p30: page 2]
Design; Copyright © 2015, Texas Instruments Incorporated; ti.com/webench; 0.05 0.10 0.15 0.20 0.25 0.30 0.35 0.40 0.45 0.50 0.55 0.60 0.65 0.70 0.75 Output Current (A); Duty Cycle(%); Cin IRMS(A); IC Ipk; IC Ipk(A)

IC Tj(degC)

Vin= 3.0V Vin= 3.6V Vin= 4.2V
Duty Cycle

Cin IRMS

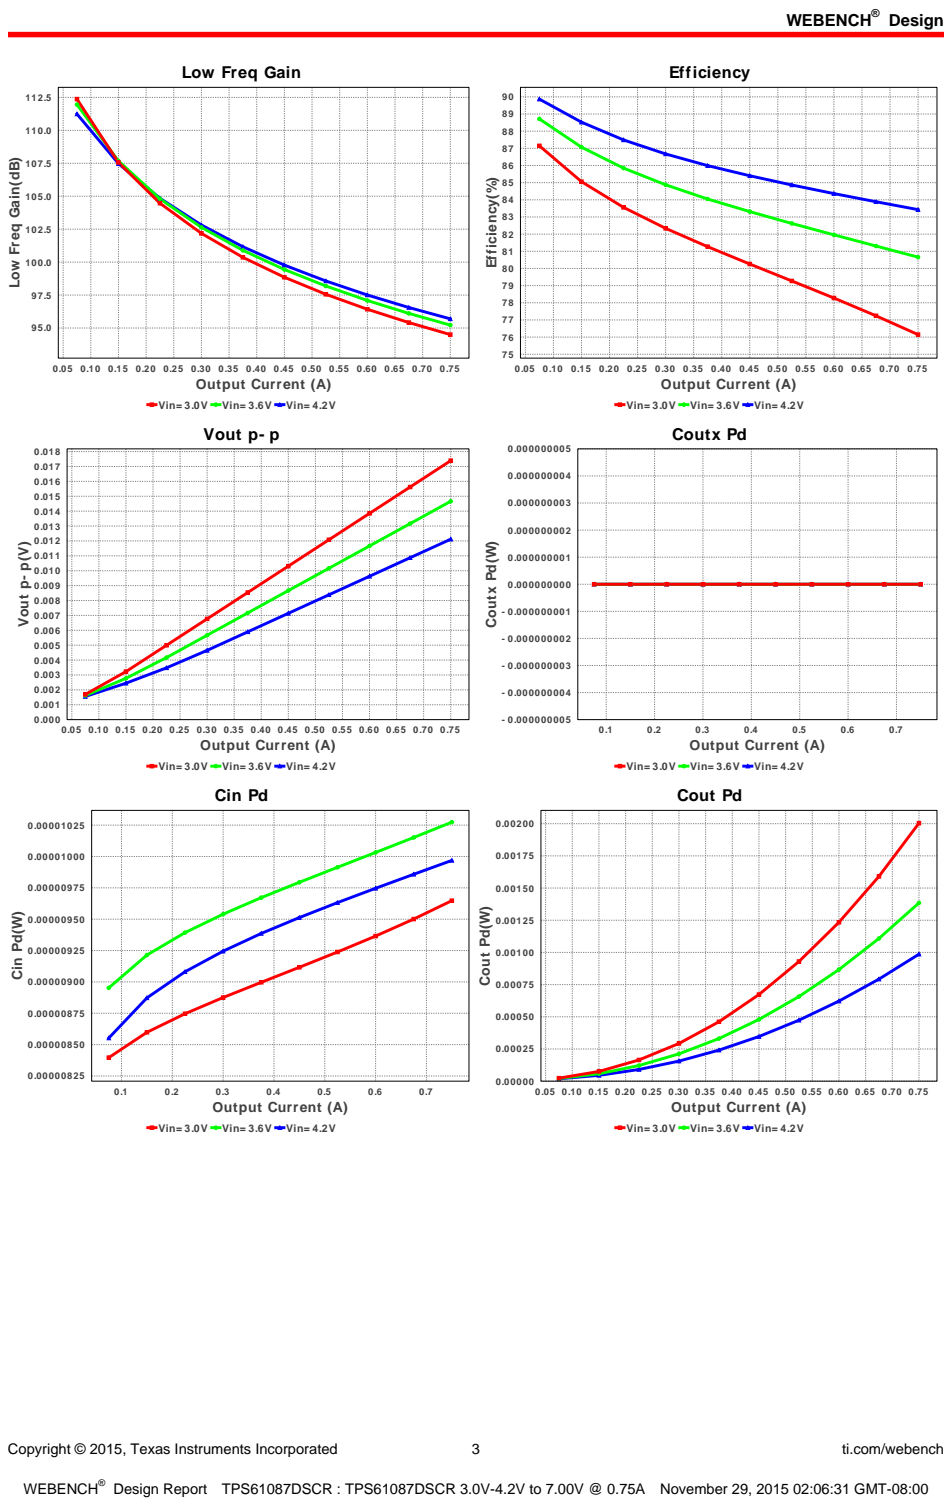
[picture p31: page 3]
Copyright © 2015, Texas Instruments Incorporated; ti.com/webench; 0.05 0.10 0.15 0.20 0.25 0.30 0.35 0.40 0.45 0.50 0.55 0.60 0.65 0.70 0.75 Output Current (A); Efficiency; Efficiency(%); Vout p- p(V); 0.7 Output Current (A); Coutx Pd(W); Cin Pd(W); Cout Pd(W)

Low Freq Gain

Low Freq Gain(dB)

Vin= 3.0V Vin= 3.6V Vin= 4.2V
Vout p- p

Coutx Pd

Cin Pd

Cout Pd

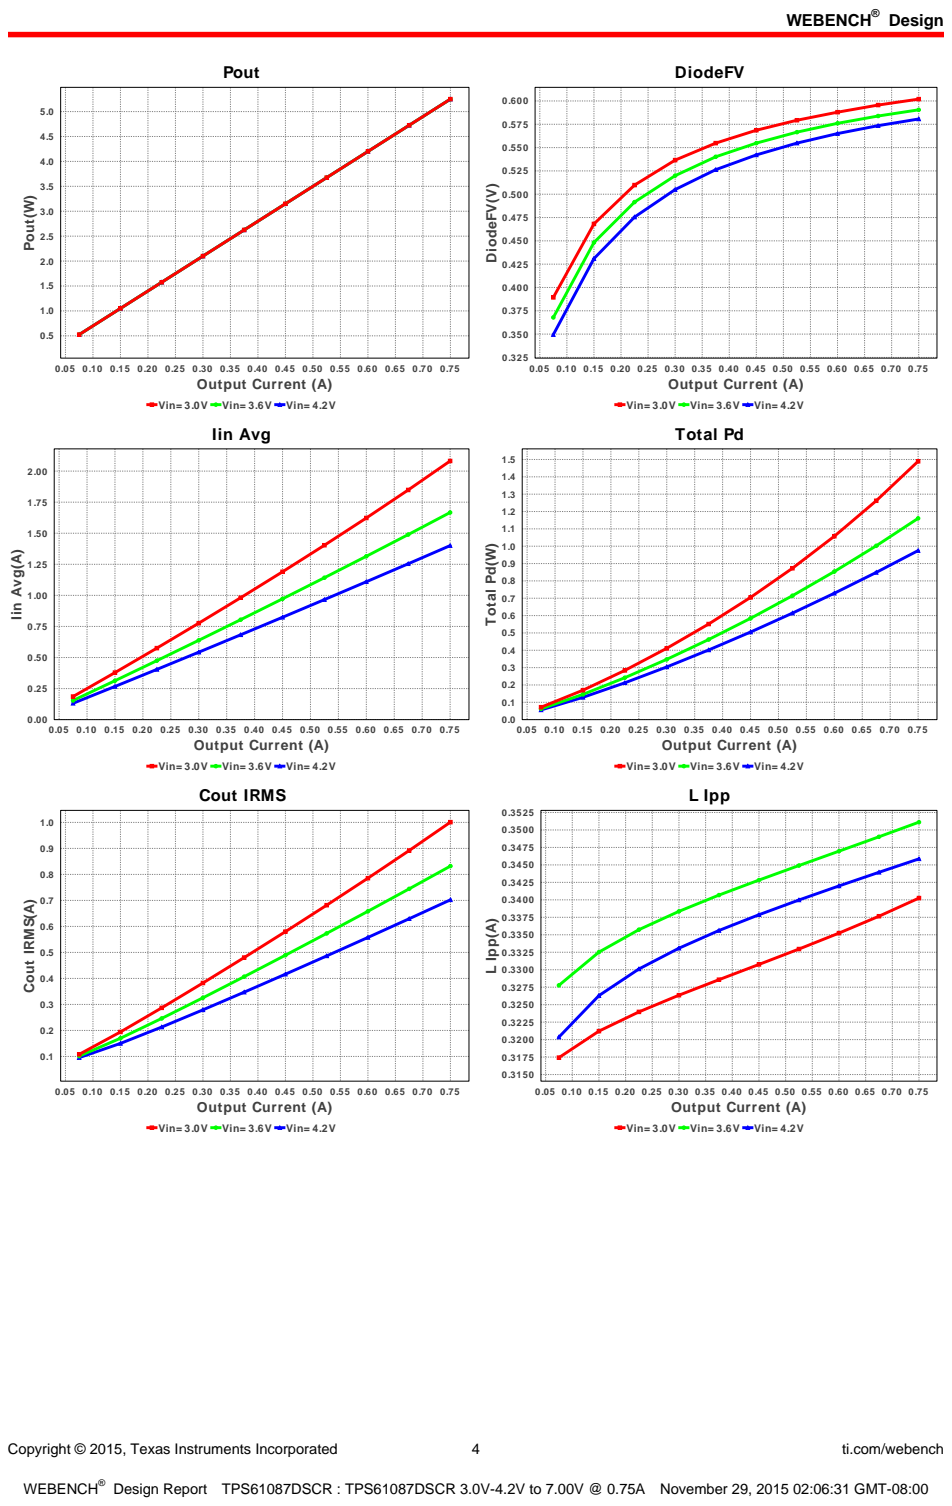
[picture p32: page 4]
Copyright © 2015, Texas Instruments Incorporated; ti.com/webench; Pout; 0.05 0.10 0.15 0.20 0.25 0.30 0.35 0.40 0.45 0.50 0.55 0.60 0.65 0.70 0.75 Output Current (A); Pout(W); DiodeFV; DiodeFV(V); Iin Avg(A); Total Pd(W); Cout IRMS(A); L Ipp; L Ipp(A)

Vin= 3.0V Vin= 3.6V Vin= 4.2V
Iin Avg

Total Pd

Cout IRMS

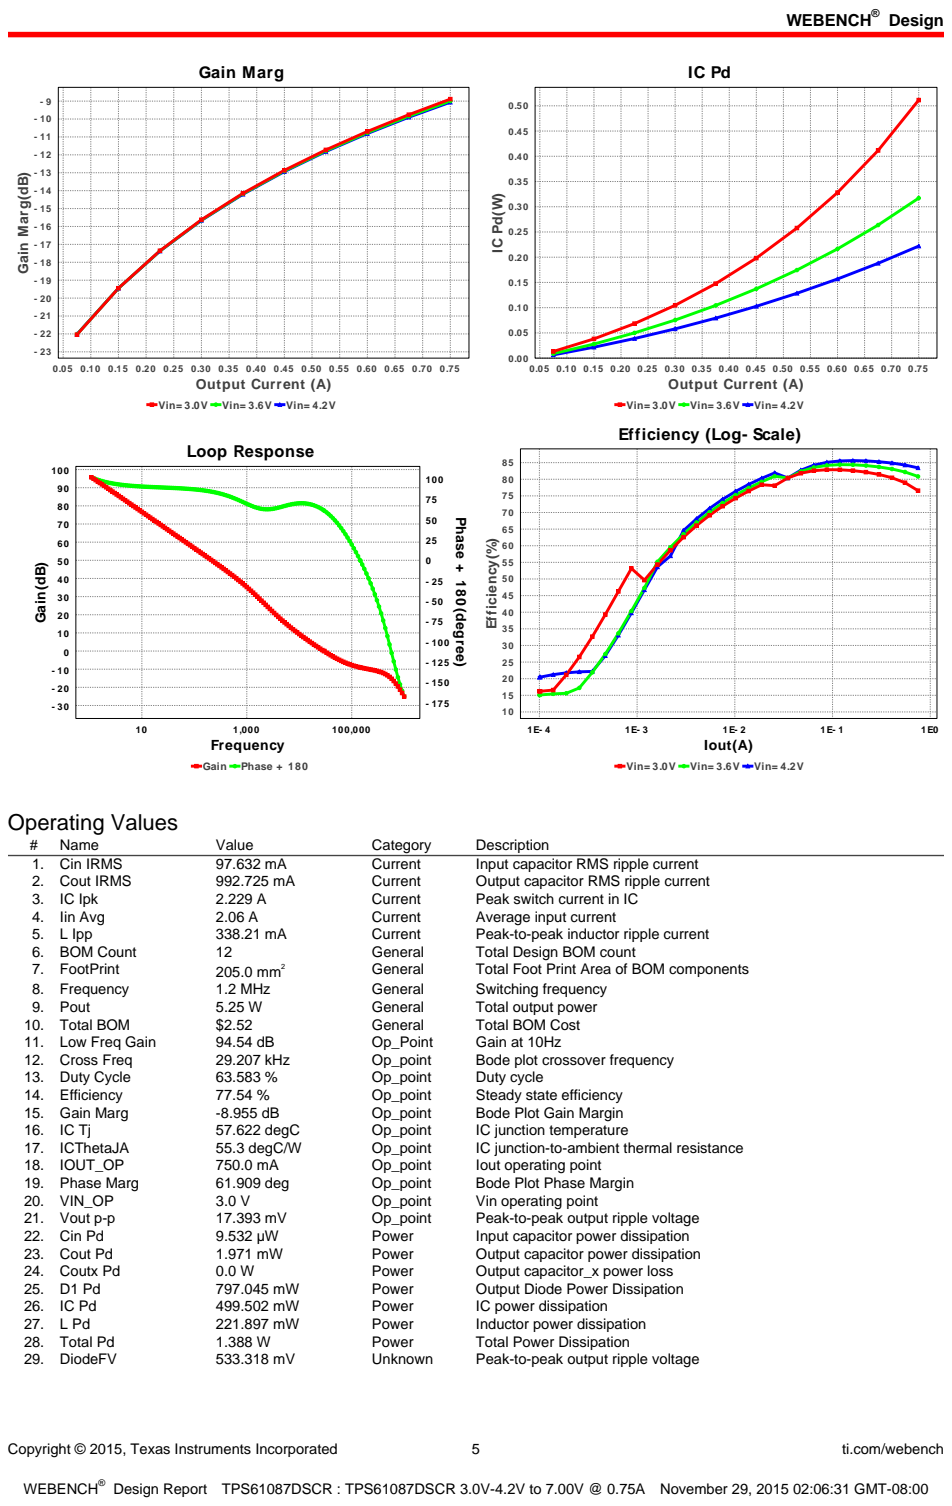
[picture p33: page 5]
Copyright © 2015, Texas Instruments Incorporated; ti.com/webench; Gain Marg; 0.05 0.10 0.15 0.20 0.25 0.30 0.35 0.40 0.45 0.50 0.55 0.60 0.65 0.70 0.75 Output Current (A); Loop Response; Gain Phase + 180; 100,000 Frequency; Gain(dB); Phase + 180(degree); Iout(A); Efficiency(%); Operating Values; Name; Value; Category; Description; 1. Cin IRMS; Current; Input capacitor RMS ripple current; 2. Cout IRMS; Output capacitor RMS ripple current; 3. IC Ipk; Peak switch current in IC; 4. Iin Avg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

Gain Marg(dB)

Vin= 3.0V Vin= 3.6V Vin= 4.2V

Efficiency (Log- Scale)

Copyright © 2015, Texas Instruments Incorporated | 6 | ti.com/webench

## Design Inputs

# | Name | Value | Description

1. Iout | 750.0 m | Maximum Output Current
2. Iout1 | 750.0 m | Output Current #1
3. VinMax | 4.2 | Maximum input voltage
4. VinMin | 3.0 | Minimum input voltage
5. Vout | 7.0 | Output Voltage
6. Vout1 | 7.0 | Output Voltage #1
7. base_pn | TPS61087 | Base Product Number
8. source | DC | Input Source Type
9. Ta | 30.0 | Ambient temperature

## Design Assistance

1. TPS61087 Product Folder : http://www.ti.com/product/TPS61087 : contains the data sheet and other resources.

Texas Instruments' WEBENCH simulation tools attempt to recreate the performance of a substantially equivalent physical implementation
of the design. Simulations are created using Texas Instruments' published specifications as well as the published specifications of other device manufacturers. While Texas Instruments does update this information periodically, this information may not be current at the time the simulation is built. Texas Instruments does not warrant the accuracy or completeness of the specifications or any information contained therein. Texas Instruments does not warrant that any designs or recommended parts will meet the specifications you entered, will be suitable for your application or fit for any particular purpose, or will operate as shown in the simulation in a physical implementation. Texas Instruments does not warrant that the designs are production worthy.
You should completely validate and test your design implementation to confirm the system functionality for your application prior to production.
Use of Texas Instruments' WEBENCH simulation tools is subject to Texas Instruments' Site Terms and Conditions of Use. (http://www.ti.com/corp/docs/legal/termsofuse.shtml) Prototype boards based on WEBENCH created designs are provided AS IS without warranty of any kind for evaluation and testing purposes and are subject to the terms of the Evaluation License Agreement. (http://www.ti.com/corp/docs/legal/termsofuse_estore.shtml)
