SteveMayze/PowerSwap/Boost/Boost.kicad_pcb

## KiCad design Boost/Boost.kicad_pcb (2015-11-05)

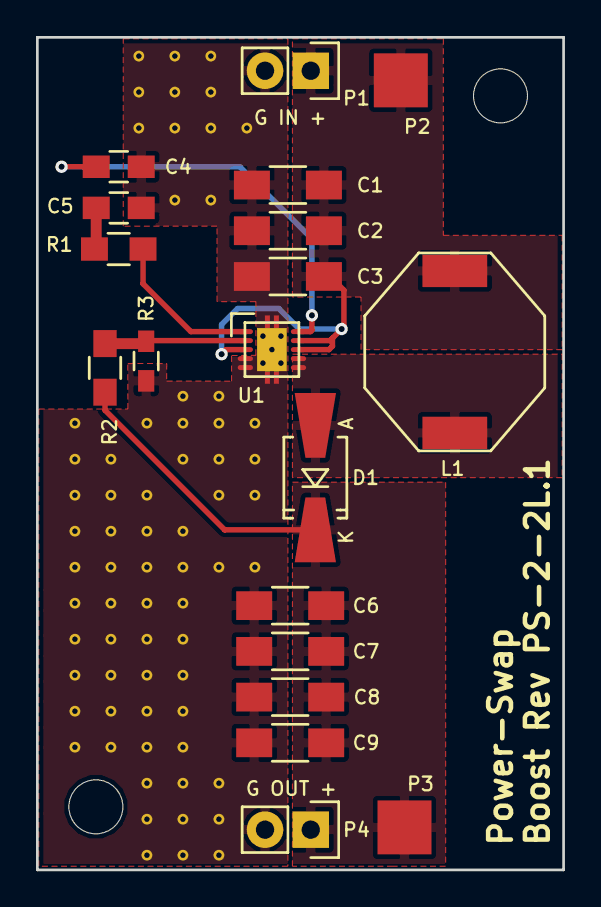
[picture p34: board Boost.kicad_pcb from above]

Board: 2 copper layers, 29.2 x 46.3 mm, 19 parts (0 on the bottom side), 8 nets.

Parts:
C1, C2, C3, C6, C7, C8, C9: 10μF; C_1206_HandSoldering
C4: 100nF; C_0805_HandSoldering
C5: 820pF; C_0805_HandSoldering
D1: 0.45V; SMA-SMB_Universal_Handsoldering
L1: 4.70H; SRU1048-4R7Y
P1, P4: CONN_01X02; Pin_Header_Straight_1x02
P2, P3: TST; Measurement_Point_Square-SMD-Pad_Big
R1: 57.6KΩ; R_0805_HandSoldering
R2: 150KΩ; R_0805_HandSoldering
R3: 39KΩ; R_0603_HandSoldering
U1: TSP61087; TPS61087DSCR

Connections:
/Comp: R1.1, U1.1
/FB: R2.2, R3.1, U1.2
/Lin: C1.1, C2.1, C3.1, L1.1, P1.1, P2.1, U1.3, U1.8, U1.9
/Lout: D1.2, L1.2, U1.6, U1.7
/SS: C4.1, U1.10
/Vout: C6.1, C7.1, C8.1, C9.1, D1.1, P3.1, P4.1, R2.1
GND: C1.2, C2.2, C3.2, C4.2, C5.2, C6.2, C7.2, C8.2, C9.2, P1.2, P4.2, R3.2, U1.4, U1.5, U1.11
unnamed: C5.1, R1.2
