SteveMayze/PowerSwap/Buck-Boost/PowerSwap.kicad_pcb

## KiCad design Buck-Boost/PowerSwap.kicad_pcb (2015-10-22)

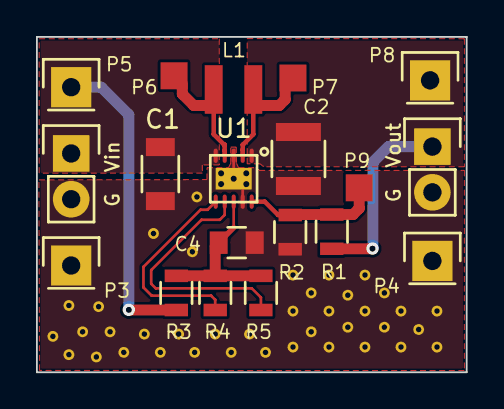
[picture p35: board PowerSwap.kicad_pcb from above]

Board: 2 copper layers, 23.9 x 18.6 mm, 19 parts (0 on the bottom side), 9 nets.

Parts:
C1: 4.7μF; C_1206
C2: 22μF; C_1210
C4: 0.1μF; C_0805
L1: 2.2μΗ; SRN3015
P1: Battery; Pin_Header_Straight_1x02
P2: Vout; Pin_Header_Straight_1x02
P3, P4, P5, P8: TST; Pin_Header_Straight_1x01
P6, P7, P9: TST; Measurement_Point_Square-SMD-Pad_Small
R1: 1.2MΩ; R_0805
R2: 215KΩ; R_0805
R3, R4, R5: 0; R_0805
U1: TPS63030

Connections:
/EN: R4.1, U1.6
/Feedback: P9.1, R1.2, R2.1, U1.10
/L1: L1.1, P6.1, U1.4
/L2: L1.2, P7.1, U1.2
/PS: R5.1, U1.7
/Vin+: C1.1, P1.1, P5.1, R3.2, U1.5
/Vina: C4.1, R3.1, R4.2, R5.2, U1.8
/Vout+: C2.1, P2.1, P8.1, R1.1, U1.1
GNDPWR: C1.2, C2.2, C4.2, P1.2, P2.2, P3.1, P4.1, R2.2, U1.3, U1.9, U1.11
