SteveMayze/PowerSwap/Boost/Reference-Layout.kicad_pcb

## KiCad design Boost/Reference-Layout.kicad_pcb (2015-10-29)

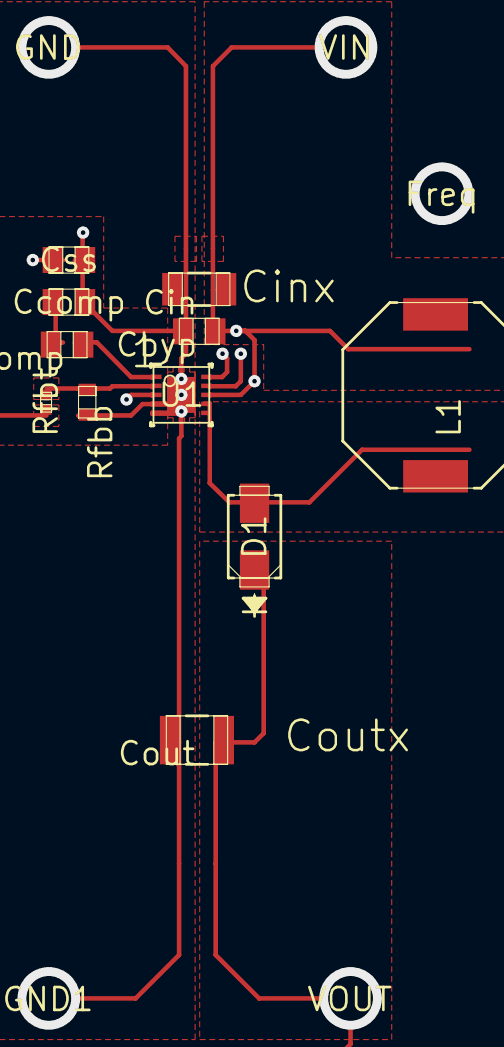
[picture p36: board Reference-Layout.kicad_pcb from above]

Board: 10 copper layers, 16 parts (0 on the bottom side), 9 nets.

Parts:
Cbyp: 0805
Ccomp: 0805
Cin: 1206
Cout: 1210
Css: 0805
D1: SMA
Freq: TP-1502
GND, GND1: TP-1502
L1: SRU1048
Rcomp: 0805
Rfbb: 0603
Rfbt: 0402
U1: DSC0010A
VIN: TP-1502
VOUT: TP-1502

Connections:
0: Cbyp.2, Ccomp.2, Cin.2, Cout.2, Css.2, GND.1, GND1.1, Rfbb.2, U1.4, U1.5, U1.11
1: Cbyp.1, Cin.1, L1.1, U1.3, U1.8, VIN.1
2: Cout.1, D1.1, Rfbt.1, VOUT.1
4: D1.2, L1.2, U1.6, U1.7
5: Rcomp.1, U1.1
6: Rfbb.1, Rfbt.2, U1.2
7: Ccomp.1, Rcomp.2
10: Css.1, U1.10
11: Freq.1, U1.9
