SteveMayze/PowerSwap/(commit log)

2015-08-01 Created the project and project sturcture
    [PowerSwap.sch]
2015-08-01 Added schematic for the power regulator
    [PowerSwap.sch]
2015-08-02 Touched up the labeling of the schematic test points and wires
    [PowerSwap.sch]
2015-08-10 Added a open office component values spreadsheet
    [ComponentValues.ods]
2015-08-11 Updated the component calculations
    [ComponentValues.ods]
2015-08-18 Added footprints for inductor and power converter
    [PowerSwap.kicad_pcb, PowerSwap.sch]
2015-08-18 Started the layout
    [PowerSwap.kicad_pcb, PowerSwap.sch]
2015-08-18 Added a couple of datasheets
2015-08-24 Completed layout
    [PowerSwap.kicad_pcb]
2015-08-27 Final layout
    [PowerSwap.kicad_pcb, PowerSwap.sch]
2015-08-28 Completed the layout and gerbers
    [PowerSwap-B_Cu.gbl, PowerSwap-B_Mask.gbs, PowerSwap-B_Paste.gbp, PowerSwap-B_SilkS.gbo, PowerSwap-Edge_Cuts.gko, PowerSwap-F_Cu.gtl, PowerSwap-F_Mask.gts, PowerSwap-F_Paste.gtp]
2015-10-22 Added some testing info and corrections
    [PowerSwap.sch, RegulatorCompare.ods]
2015-10-22 Added BOM
    [PowerSwap.csv]
2015-10-22 Fixed the TPS63030 footprint and cleaned up the layout
    [PowerSwap.kicad_pcb, PowerSwap.sch]
2015-10-22 Created Gerbers for 2L.2-c220856
    [PowerSwap-B_Cu.gbl, PowerSwap-B_Mask.gbs, PowerSwap-B_Paste.gbp, PowerSwap-B_SilkS.gbo, PowerSwap-Edge_Cuts.gko, PowerSwap-F_Cu.gtl, PowerSwap-F_Mask.gts, PowerSwap-F_Paste.gtp]
2015-10-22 Added tracks to GND of the TPS63030
    [PowerSwap-B_Cu.gbl, PowerSwap-B_Mask.gbs, PowerSwap-B_Paste.gbp, PowerSwap-B_SilkS.gbo, PowerSwap-Edge_Cuts.gko, PowerSwap-F_Cu.gtl, PowerSwap-F_Mask.gts, PowerSwap-F_Paste.gtp]
2015-10-29 Moved the kicad to Buck-Boost and created the Boost directory
    [ComponentValues.ods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]
2015-10-29 Added the reference layout and created the initial schematic based on the reference circuit
    [Boost.kicad_pcb, Boost.sch, Reference-Layout.kicad_pcb, tps61087-BOM.xls]
2015-11-02 Created the foot prints for the inductor and regulator and imported to the PCB
    [Boost.kicad_pcb, Boost.sch]
2015-11-03 Components in position for the layout
    [Boost.kicad_pcb, Boost.sch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]
2015-11-03 Added power planes for the layout
    [Boost.kicad_pcb]
2015-11-03 Added routing to the layout
    [Boost.kicad_pcb]
2015-11-03 Added stitching and labels
    [Boost.kicad_pcb]
2015-11-04 Added the layout diagram and updated the version information on the board
    [Boost.kicad_pcb]
2015-11-04 Created Gerbers and stinsil file
    [Boost-B_Cu.gbl, Boost-B_Mask.gbs, Boost-B_Paste.gbp, Boost-B_SilkS.gbo, Boost-Edge_Cuts.gko, Boost-F_Cu.gtl, Boost-F_Mask.gts, Boost-F_Paste.gtp]
2015-11-05 Cleaned up the layout in preperation for gerbers. Made some pads solid rather than from parent
    [Boost.kicad_pcb]
2015-11-05 Finalised the gerbers
    [Boost-B_Cu.gbl, Boost-B_Mask.gbs, Boost-B_Paste.gbp, Boost-B_SilkS.gbo, Boost-Edge_Cuts.gko, Boost-F_Cu.gtl, Boost-F_Mask.gts, Boost-F_Paste.gtp]
2015-11-20 Added text annotations for input and output voltage
    [PowerSwap.sch]
2015-11-20 Added initial documentation for the usage and test results
    [PowerSwap-BuckBoost-TestResults.ods]
2015-11-29 Corrected C3 from 10uF to 1uF
    [Boost.sch]
2015-11-29 Finalised the result data for the buck-boost data sheet
    [Boost.sch, PowerSwap-BuckBoost-TestResults.ods, PowerSwap.sch]
2015-11-29 Updated the testing results for buck-boost and boost
    [PowerSwap-Boost-TestResults.ods, PowerSwap-BuckBoost-TestResults.ods]
